University-of-Dayton-DIMLab/Smart-Nozzle/README.md

# Smart Nozzle

Soft Robotics Project Intended for Industrial Coolant Applications
