University-of-Dayton-DIMLab/Smart-Nozzle/Documentation/Progress Powerpoints/5.pptx

## 5/25/2022

## Last Week

- Touch base with kyle and find good assembly
- Print design
- 2 designs, fins and bias
- Work on whatever kyle didn’t finish
- Helix exploration
- Refine 3 chamber design

## Biased model

- 20 degree bend added to Kyle’s printed model

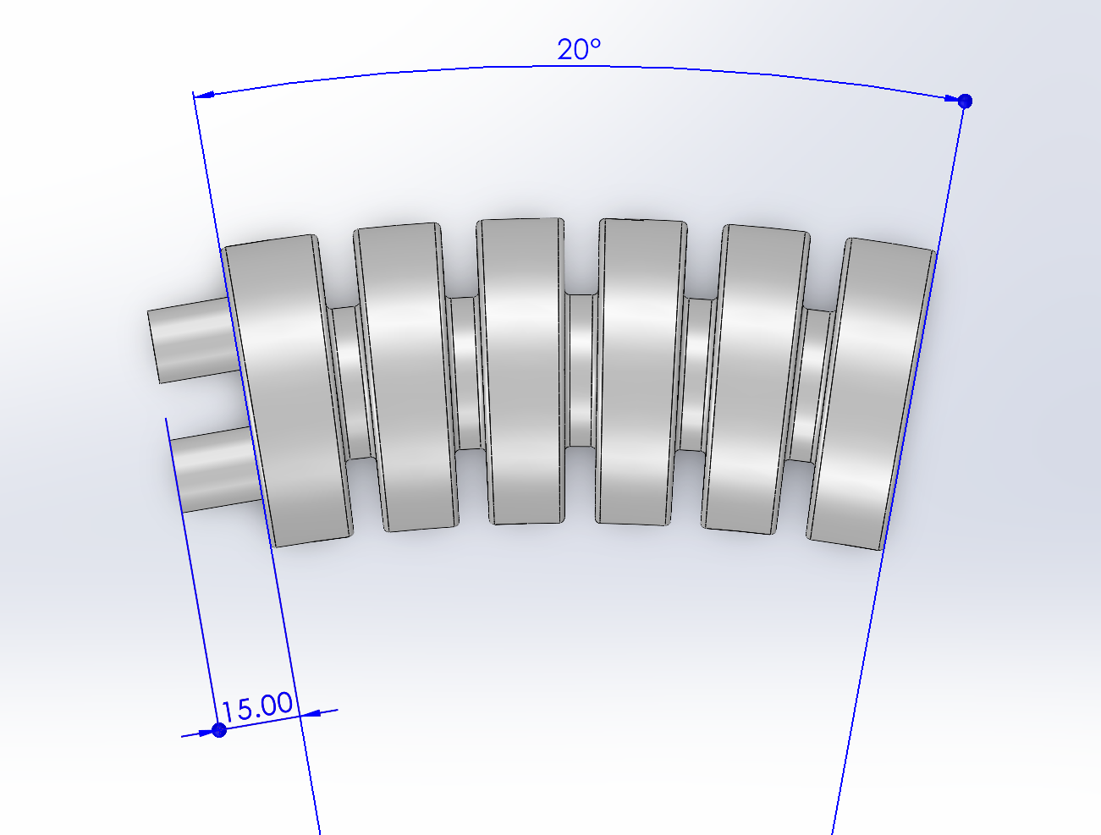
[picture p37: figure]

## Biased model with vacuum

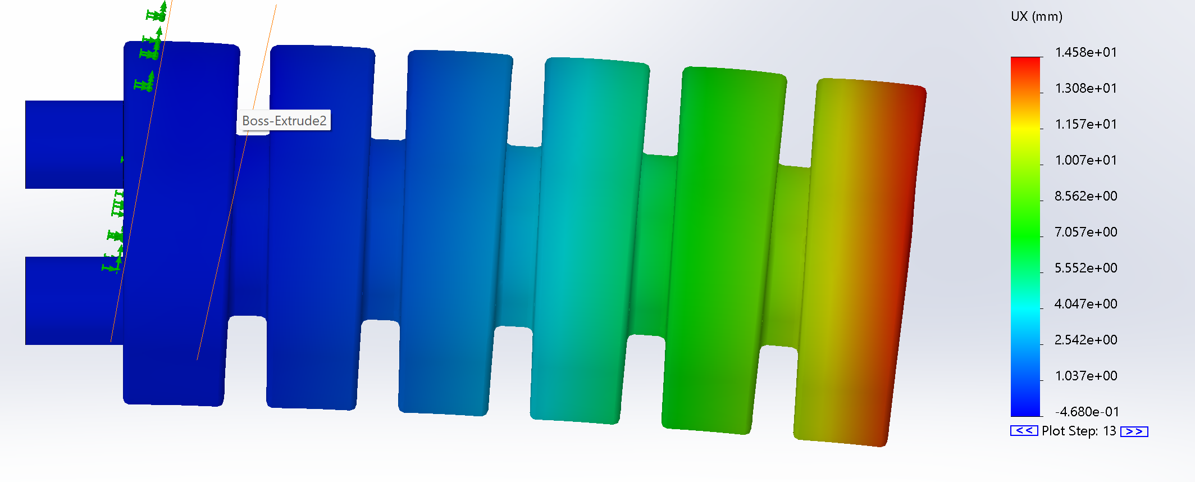
[picture p38: figure]

## Bottom chambers pressurized

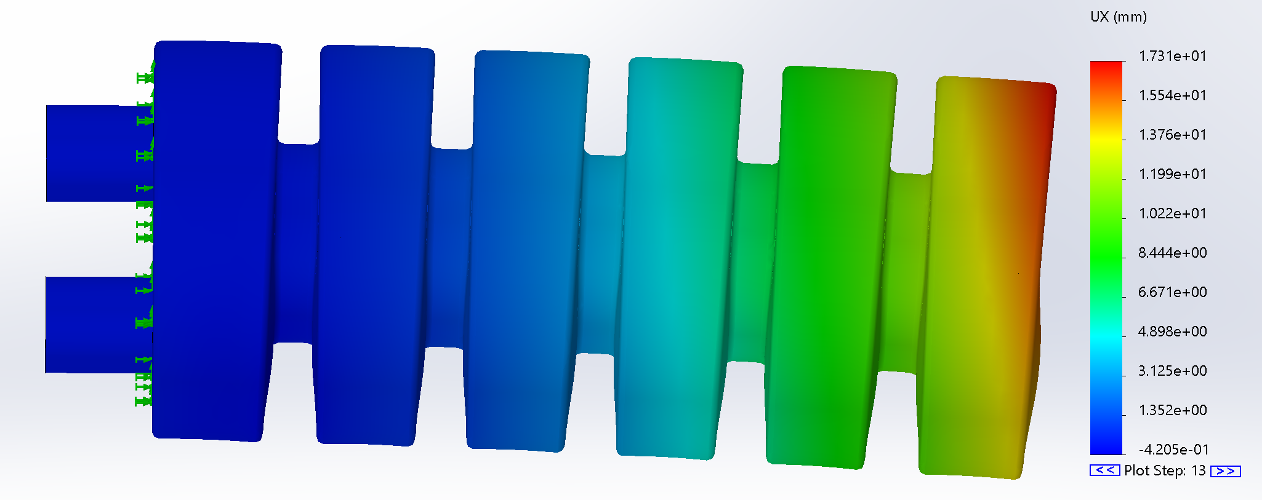
[picture p39: figure]

## Fin Model

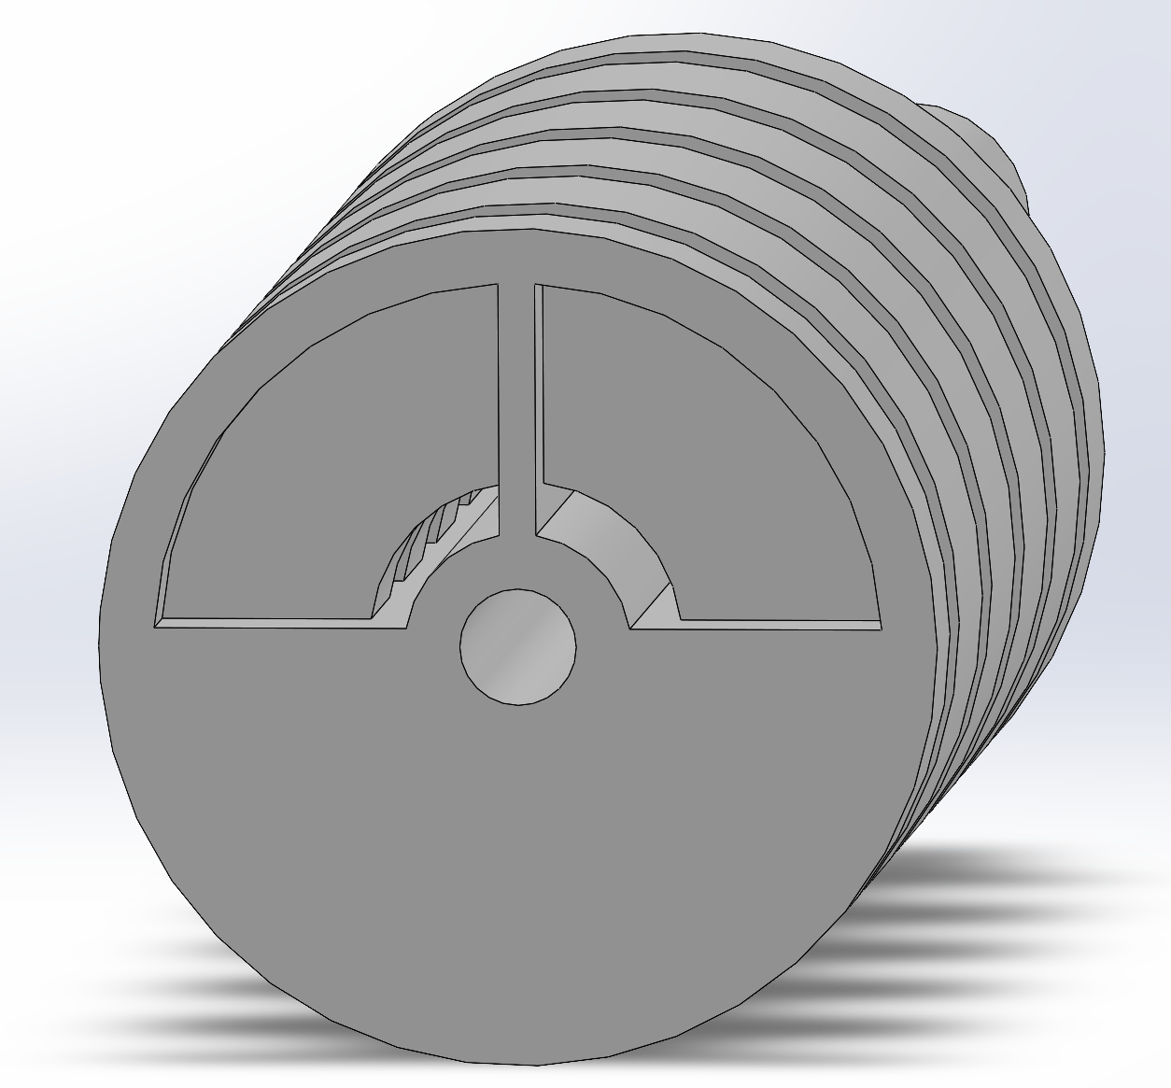
[picture p40: figure]

## Fin Model

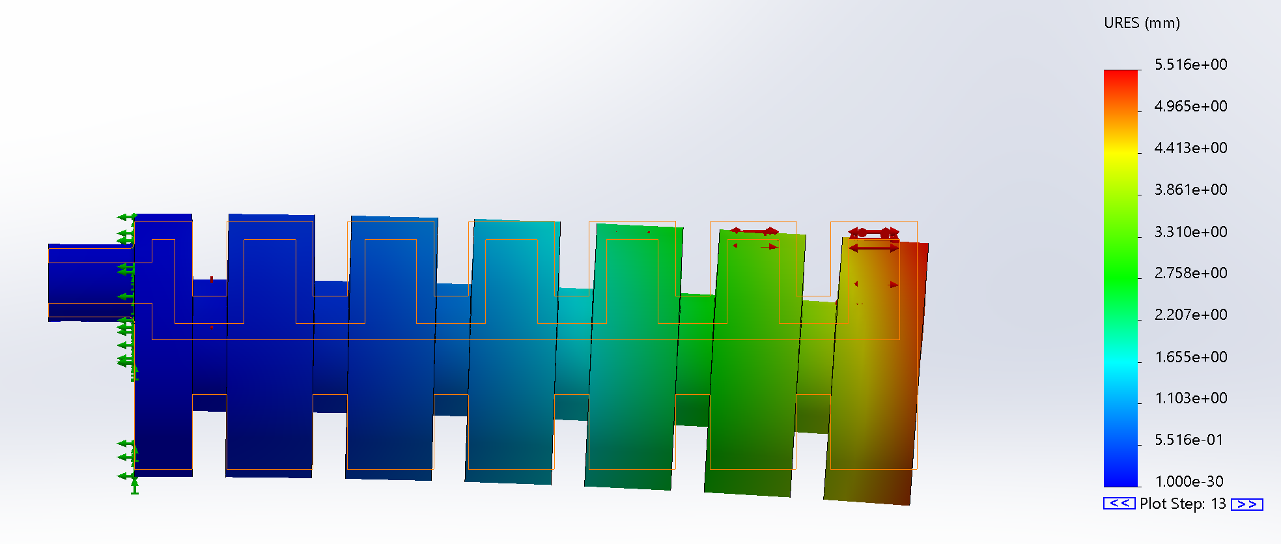
[picture p41: figure]

## Non fin model for control

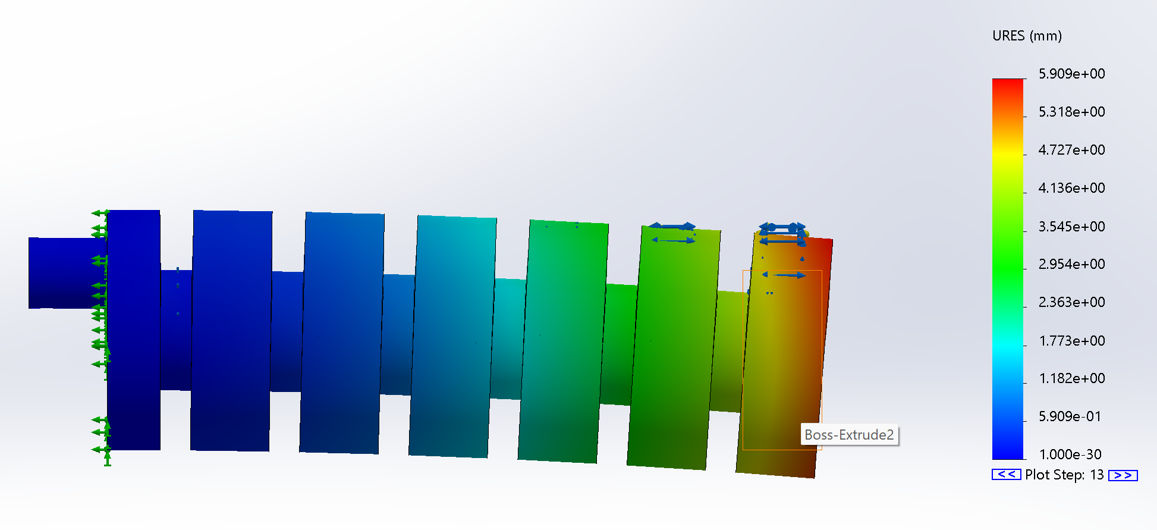
[picture p42: figure]

## Fin One Chamber

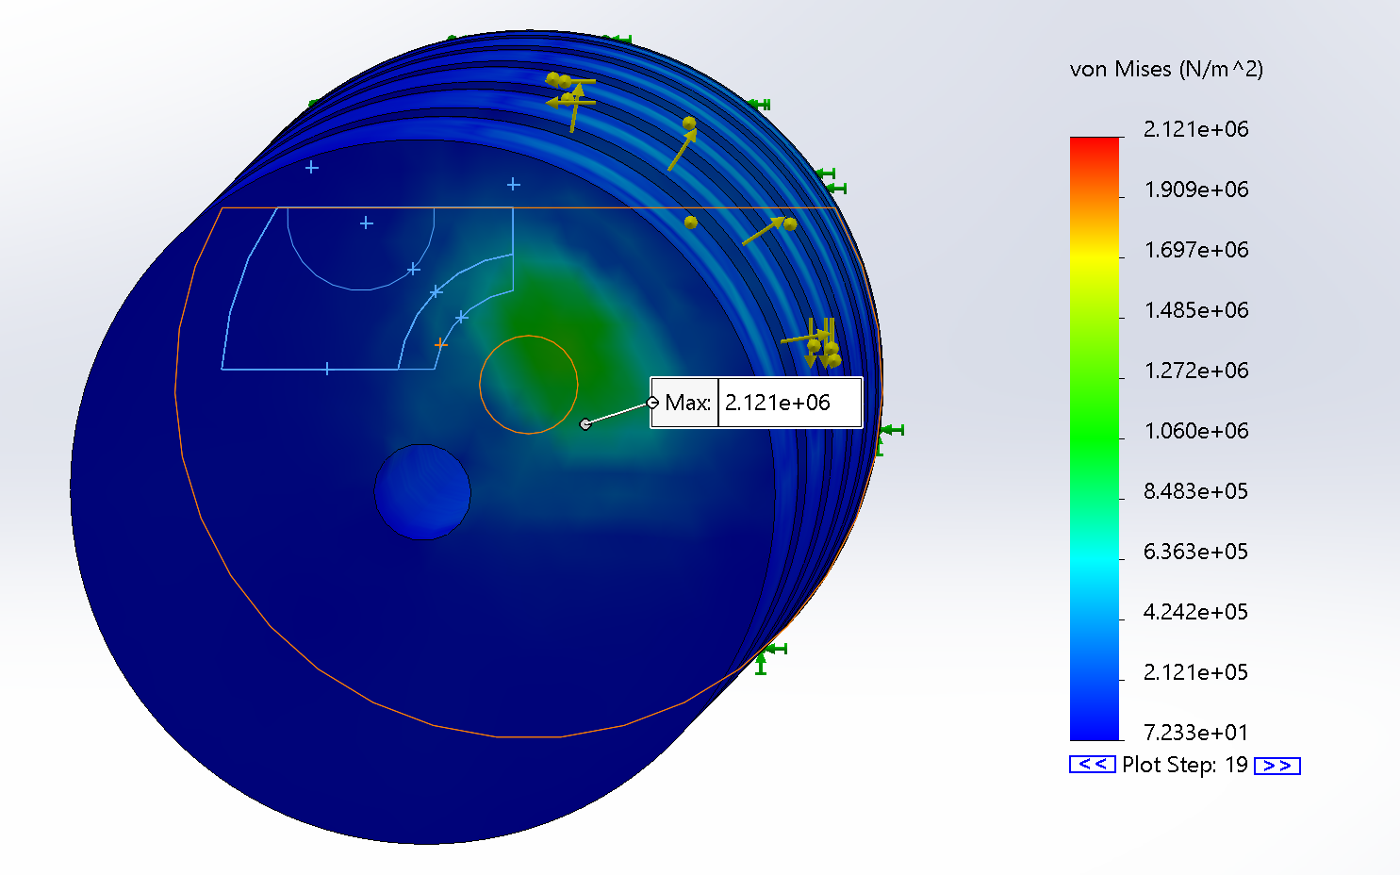
[picture p43: figure]

## Helix

- 24 mm pitch 1 cm OD 6mm ID Centered Hole

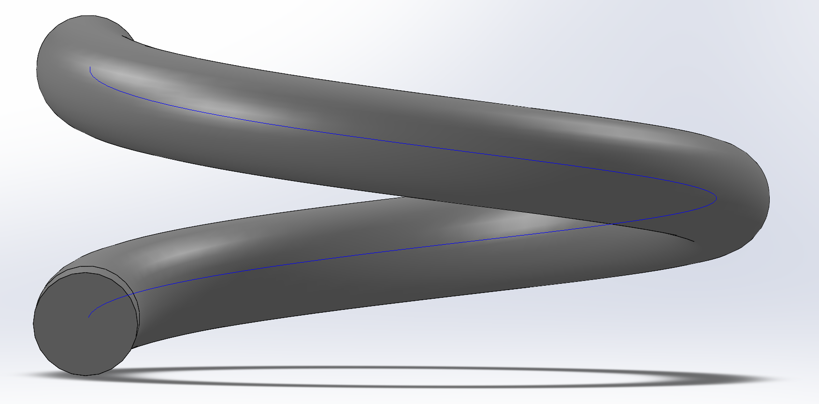
[picture p44: figure]
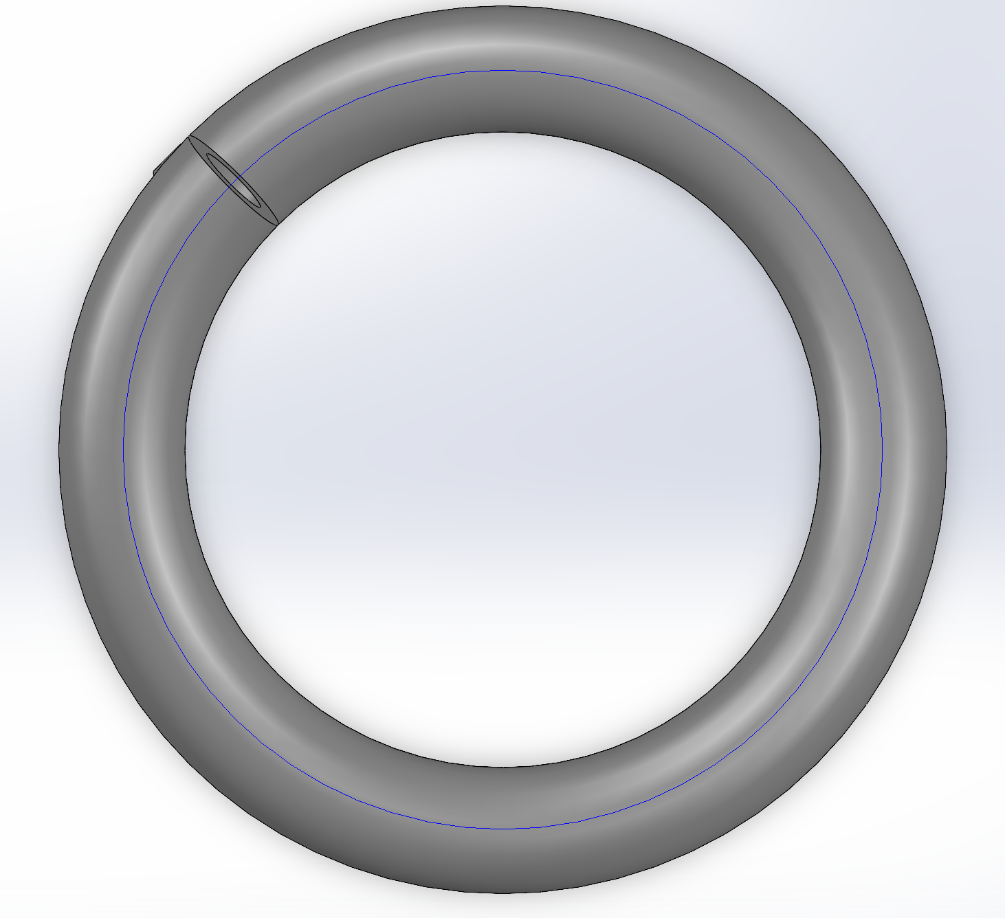
[picture p45: figure]

## Slide 11

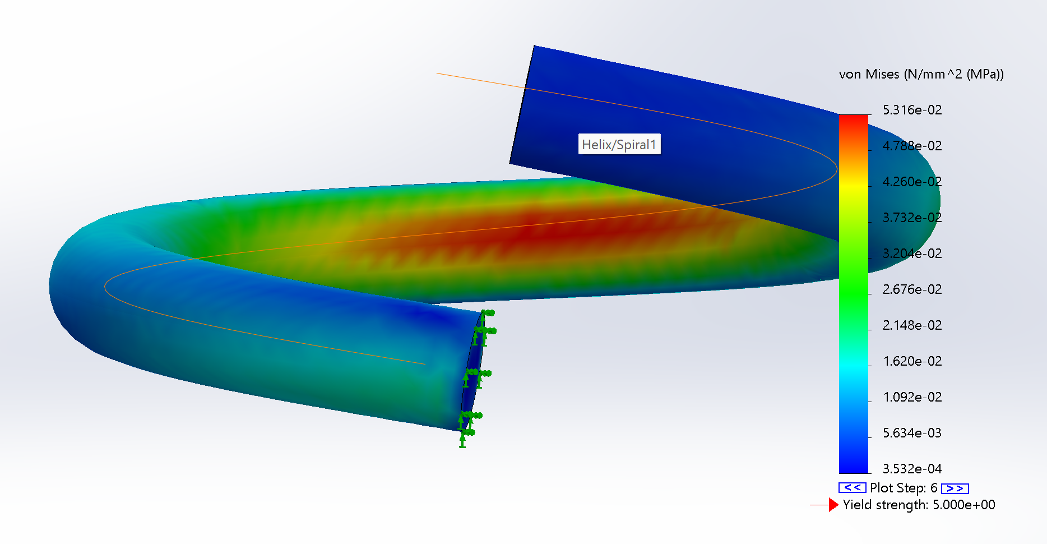
[picture p46: figure]

## For Next Week

- Develop two new models
  - Biased model with cylindric pieces not using flex tool
  - Fin design without fins
- Rebuild 3 chamber to proper spec
- Simulate the four models (two above, 3 and 4 chamber designs)
  - Run same simulations on all models to draw comparisons
- More iterations of the Helix (square)
- Follow up with Ally about print request Friday early or Thursday late
- Check in with Kyle about simulations on his models to check validity
