University-of-Dayton-DIMLab/Smart-Nozzle/Documentation/Progress Powerpoints/6-1-22.pptx

## From Last Weeks Meeting

- Develop two new models
  - Biased model with cylindric pieces not using flex tool
  - Fin design without fins
- Rebuild 3 chamber to proper spec
- Simulate the four models (two above, 3 and 4 chamber designs)
  - Run same simulations on all models to draw comparisons
- Follow up with Ally about print request Friday early or Thursday late
- Check in with Kyle about simulations on his models to check validity
- More iterations of the Helix (square)

6/1/22

## 3 Chamber

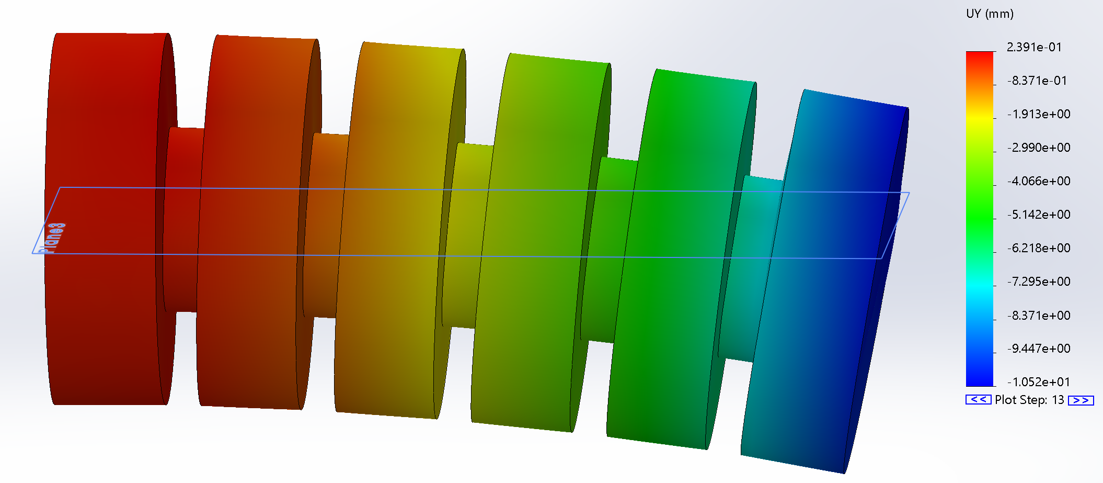
[picture p47: figure]
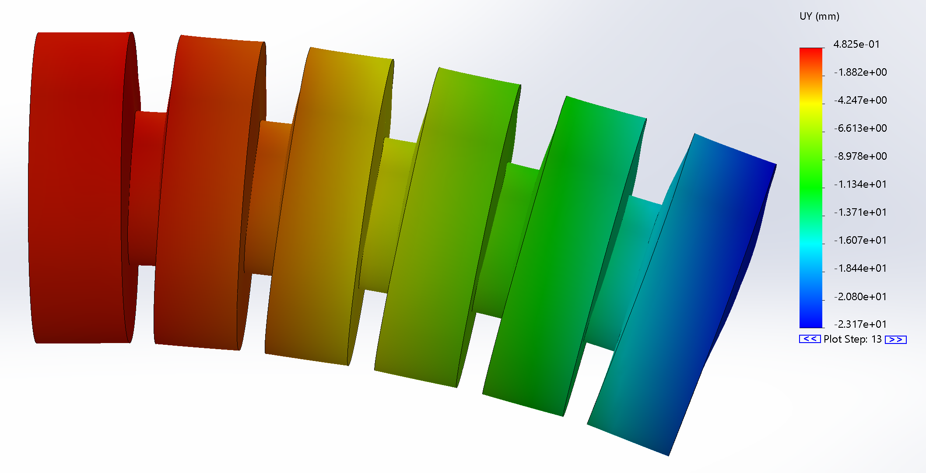
[picture p48: figure]
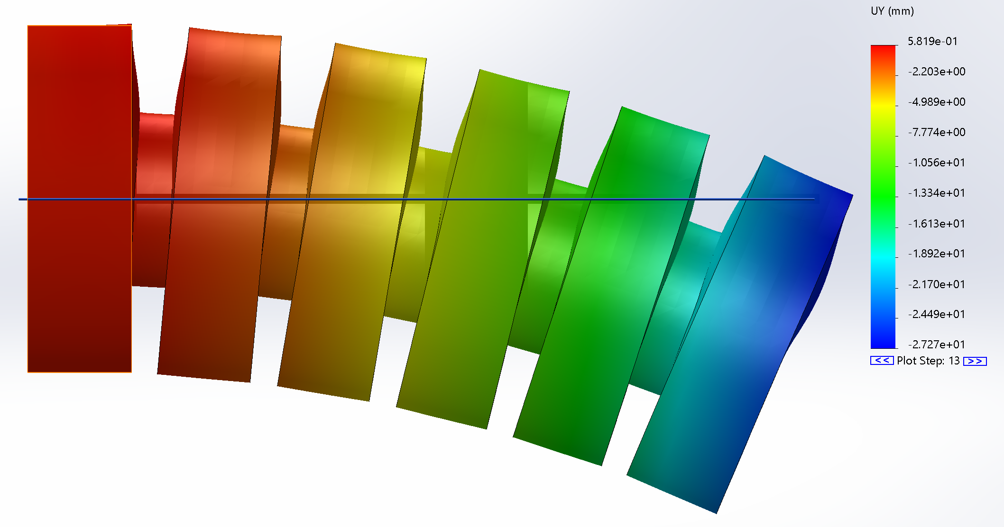
[picture p49: figure]

## 4 Chamber

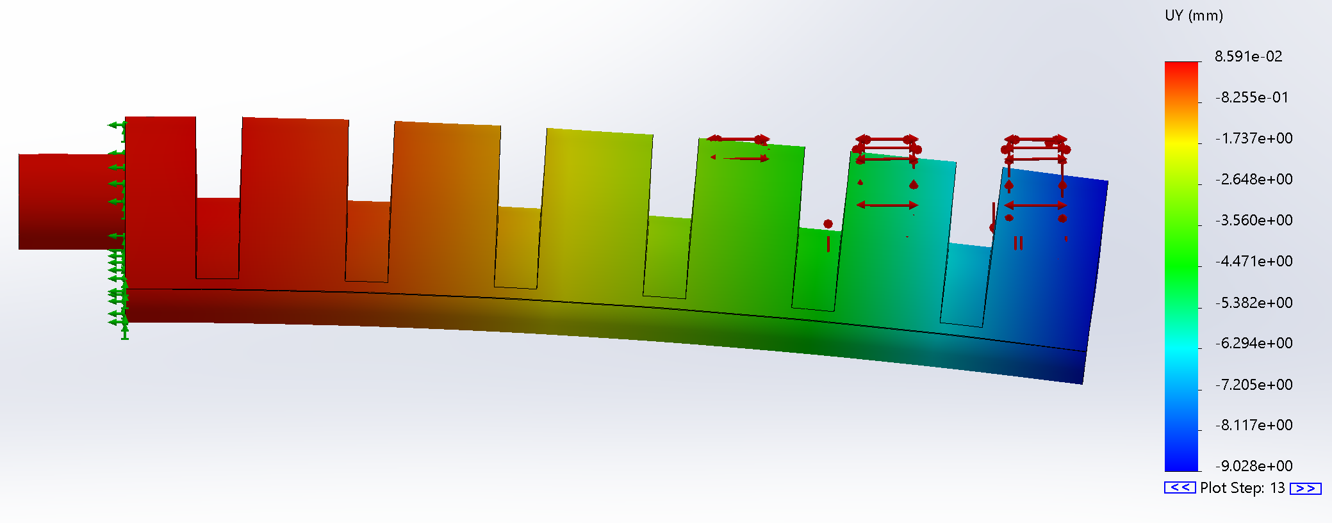
[picture p50: figure]
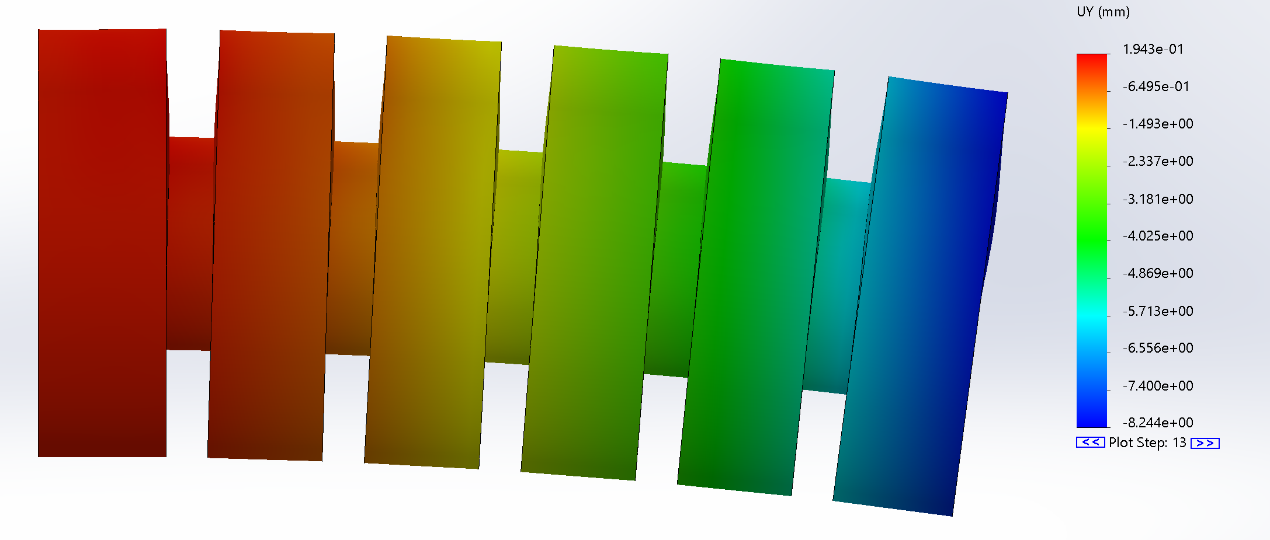
[picture p51: figure]
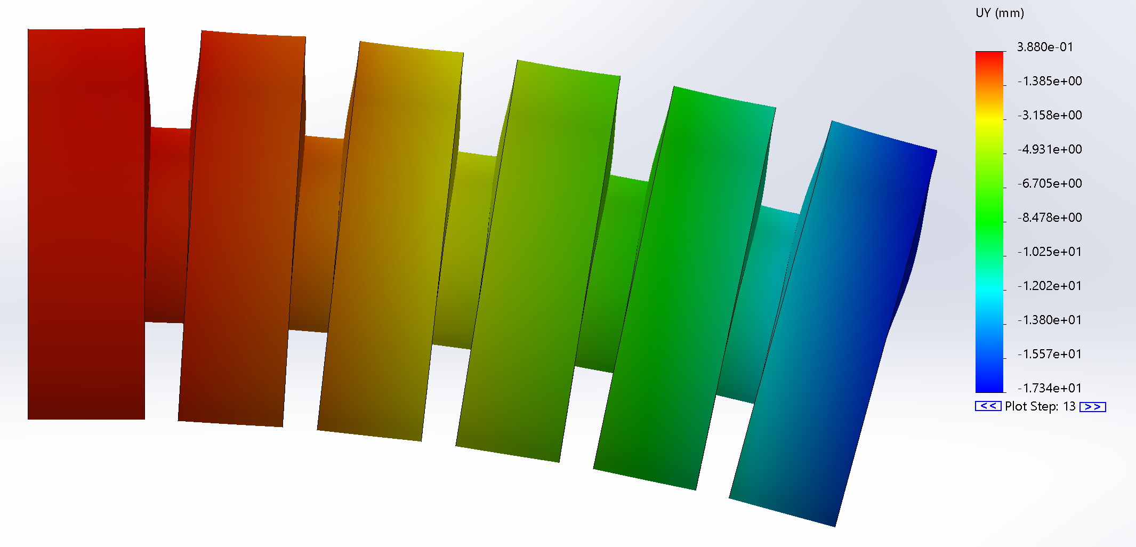
[picture p52: figure]
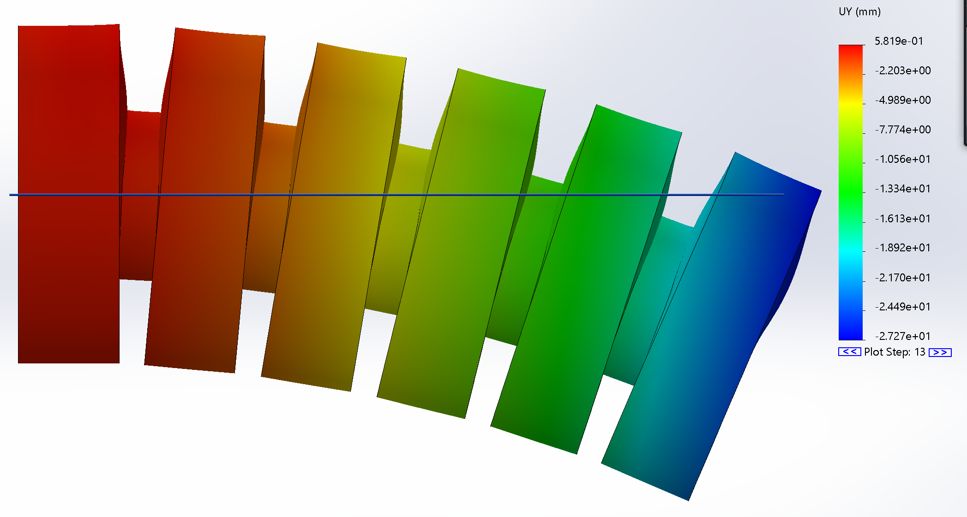
[picture p53: figure]

## Finless Model

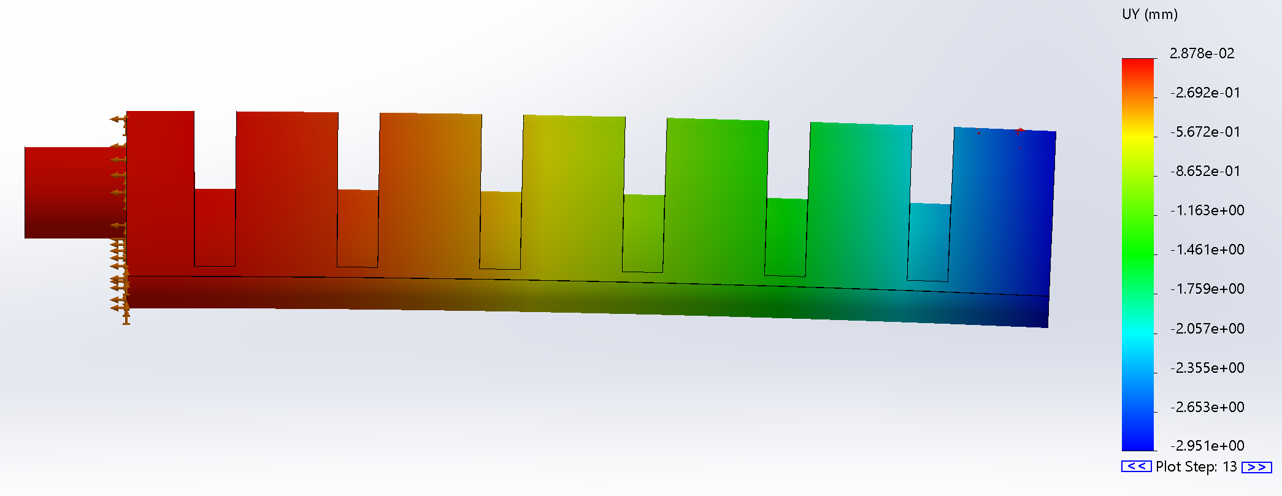
[picture p54: figure]
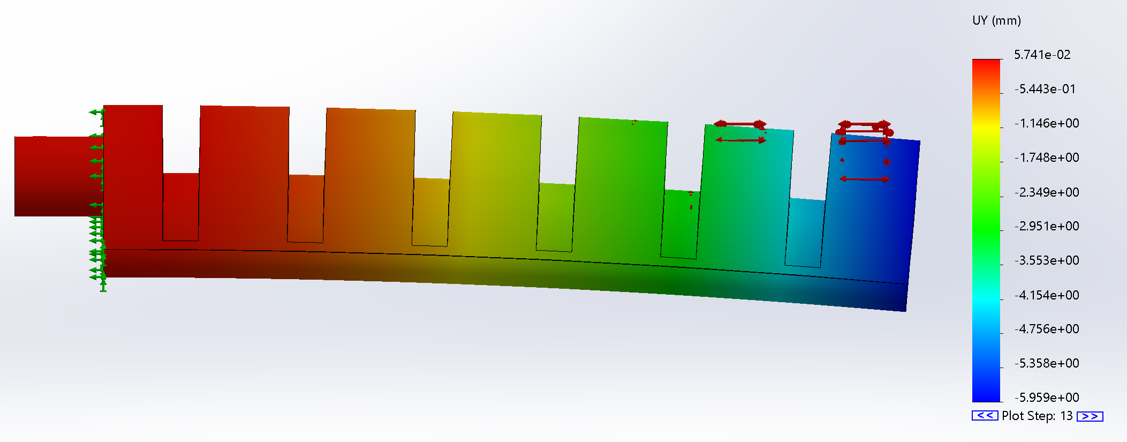
[picture p55: figure]

## For Next Week

- Reach out to jack about 272
- Prove symmetry for 0 10, 10 0 for 3 and 4 chamber design
- Further explore controllability of each nozzle design
  - 0-30psi
  - Build Table as discussed
- Build and simulate finless model to proper spec
- Remind Drew to email Ally if we haven’t heard from her
- Work on square helix design
