University-of-Dayton-DIMLab/Smart-Nozzle/Documentation/Progress Powerpoints/6-29-22.pptx

## Last Week

- Make PowerPoint For Friday
  - Get more pictures of bad prints
  - What Questions need to come up?
    - What can we do for the next print? What can they do for the next print? Questions like this need to come up
- Build Testing Rig after part delivery
- Hopefully meeting leads to work (Fri 9:15am)
  - Embrace variety around the two chamber model. Larger filets and rounds. Donuts instead of burgers. 4 chambers . 6 chambers but small. Brat size instead of white claw size. Get varieties of each
- Helix with offset chamber and more space between layers
- Hexagonal/Octagonal helix
- Review assembling and animating a 4 bar mechanism connected by revolute or prismatic joints

## Highlighter design

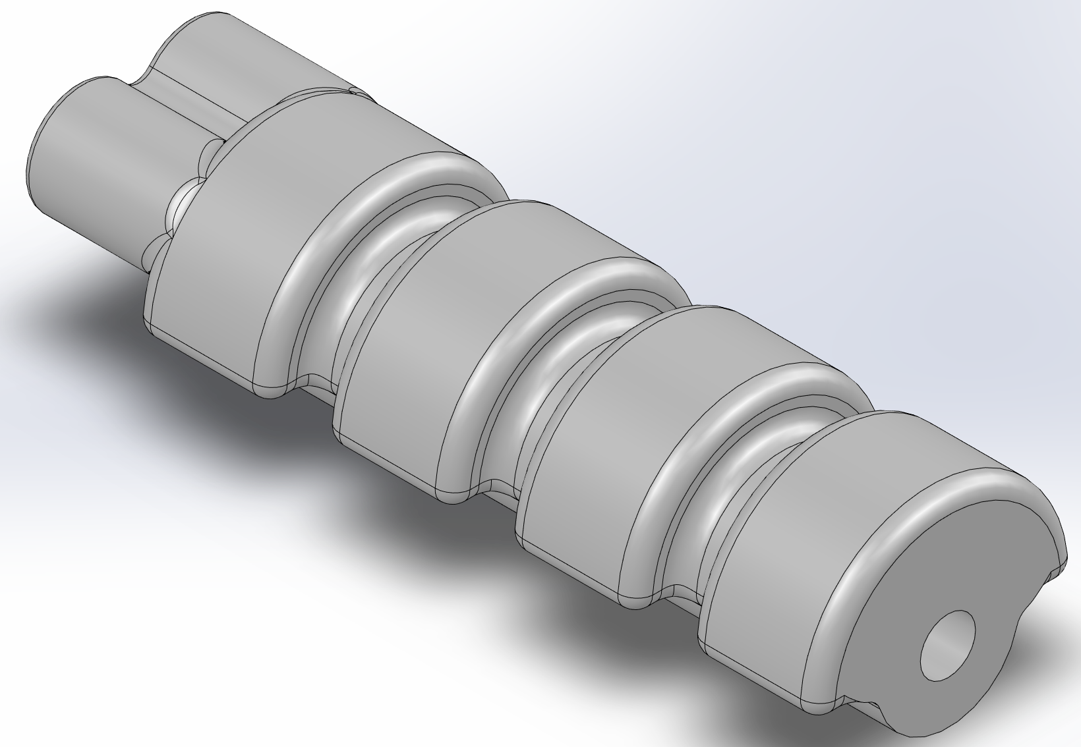
[picture p56: figure]
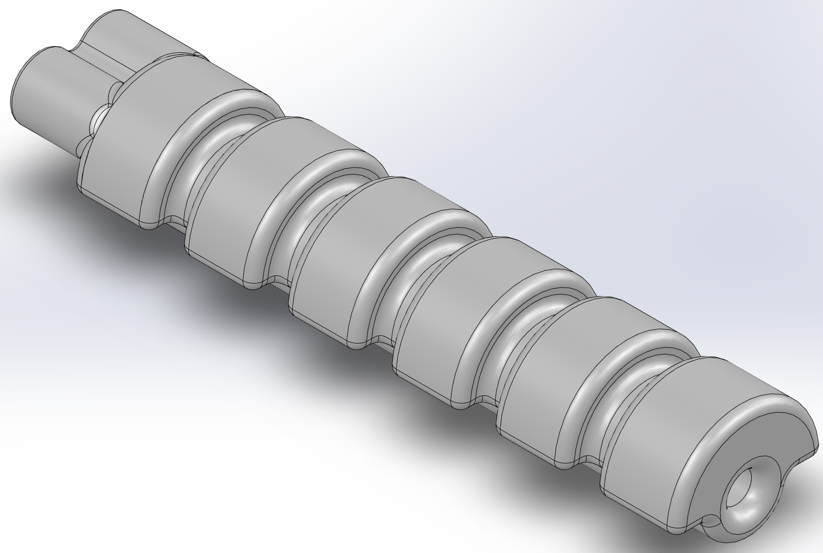
[picture p57: figure]
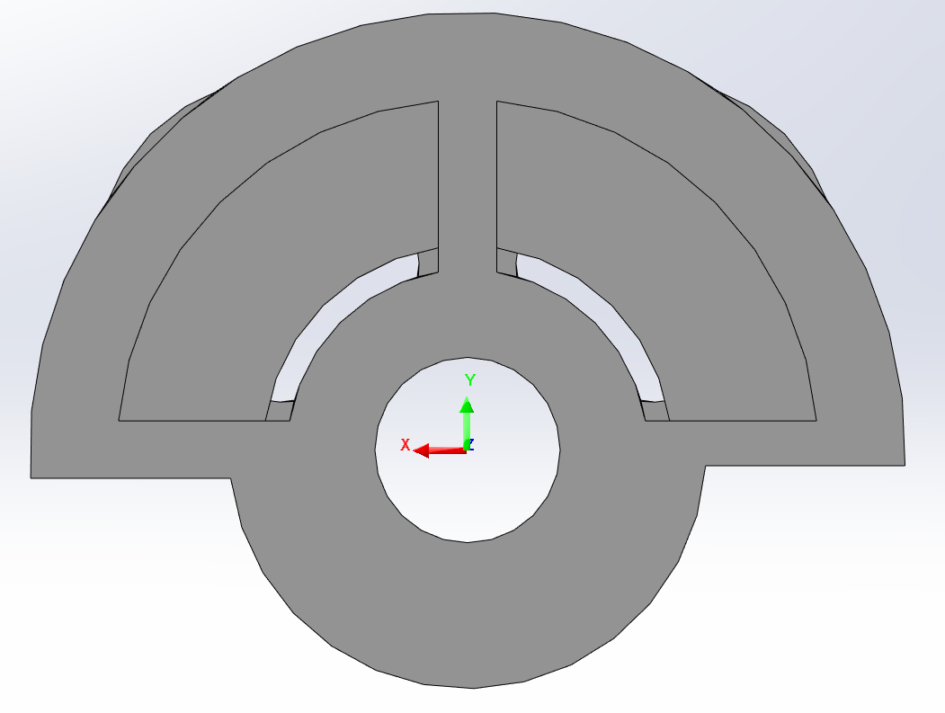
[picture p58: figure]

## Torus Design

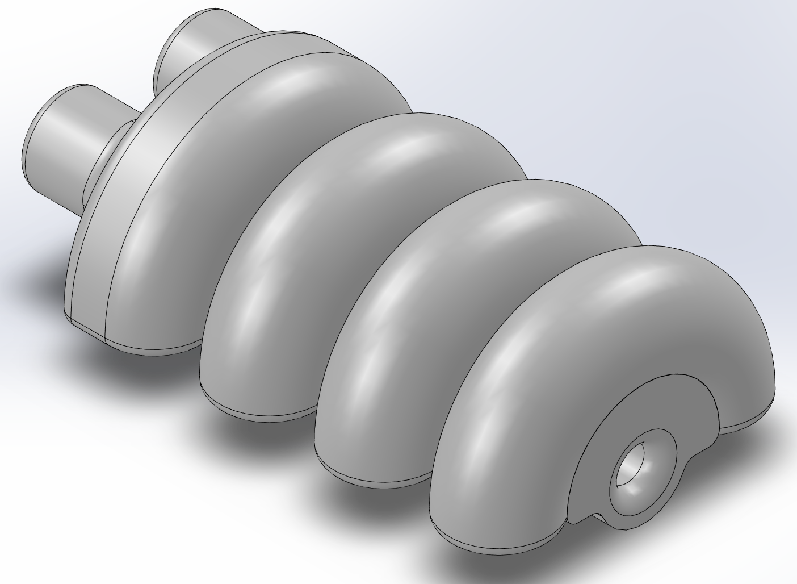
[picture p59: figure]
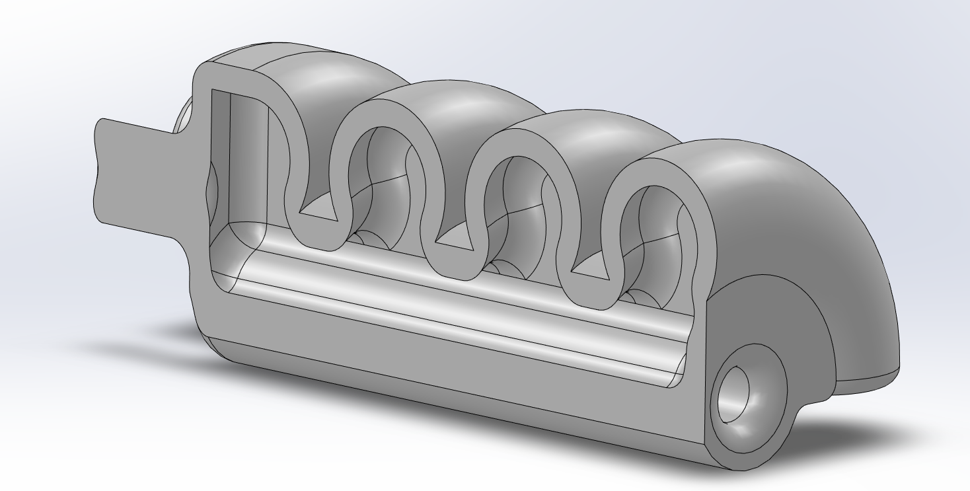
[picture p60: figure]
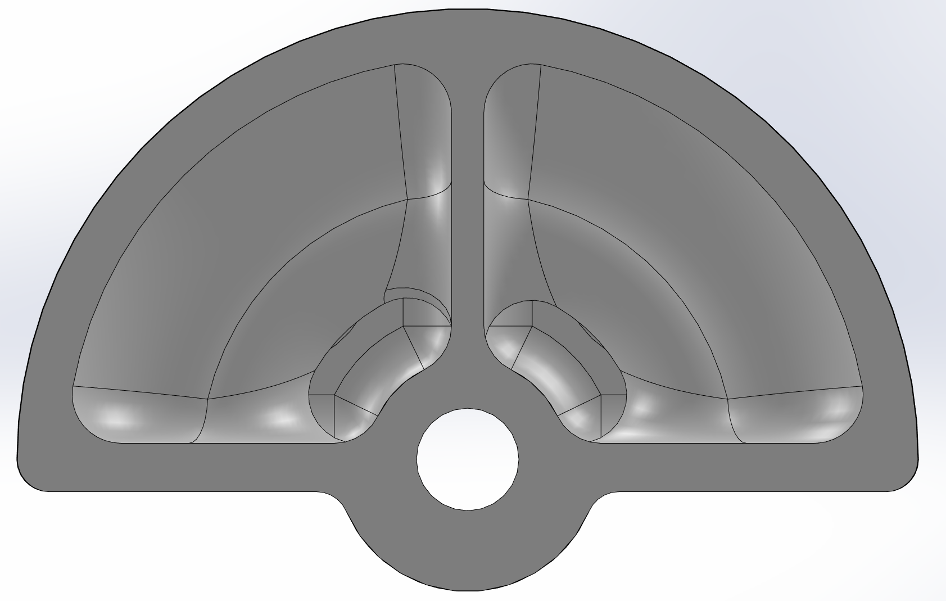
[picture p61: figure]
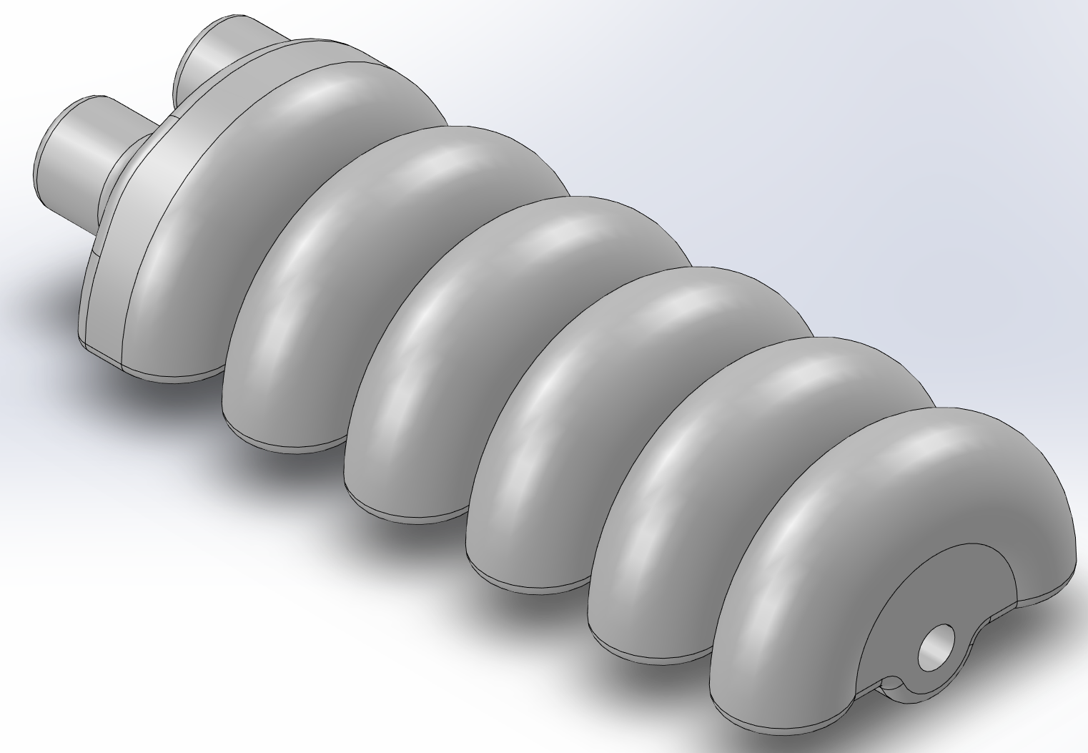
[picture p62: figure]

## Larger Fillets

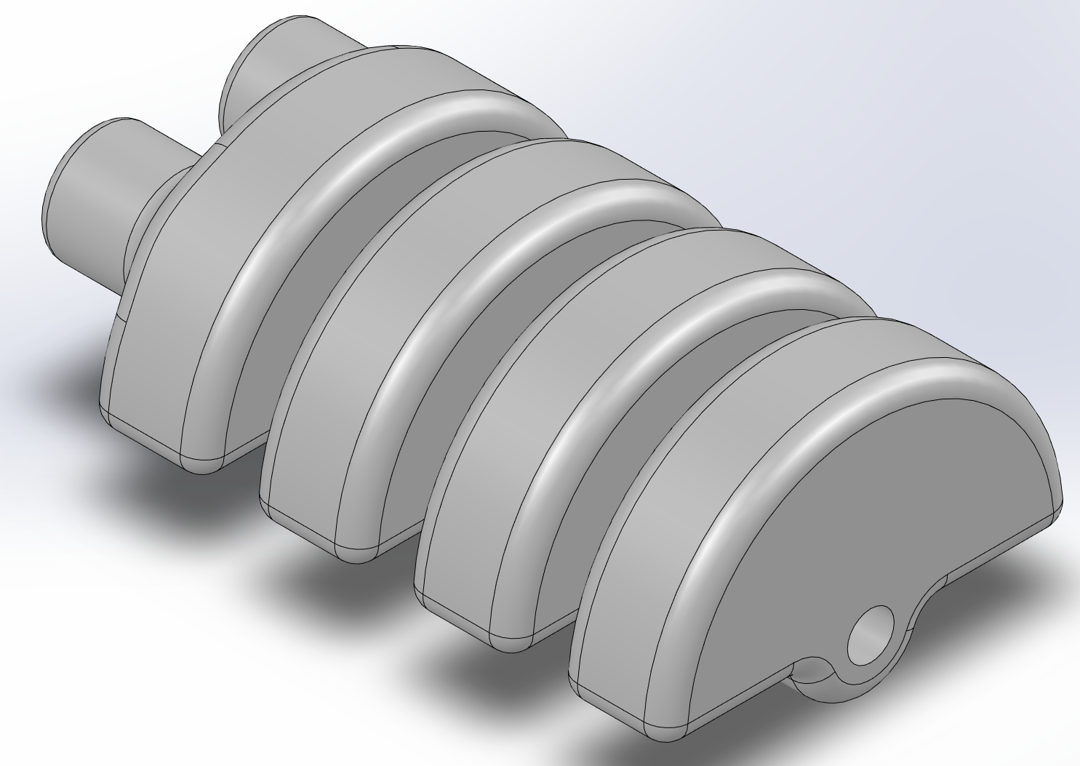
[picture p63: figure]
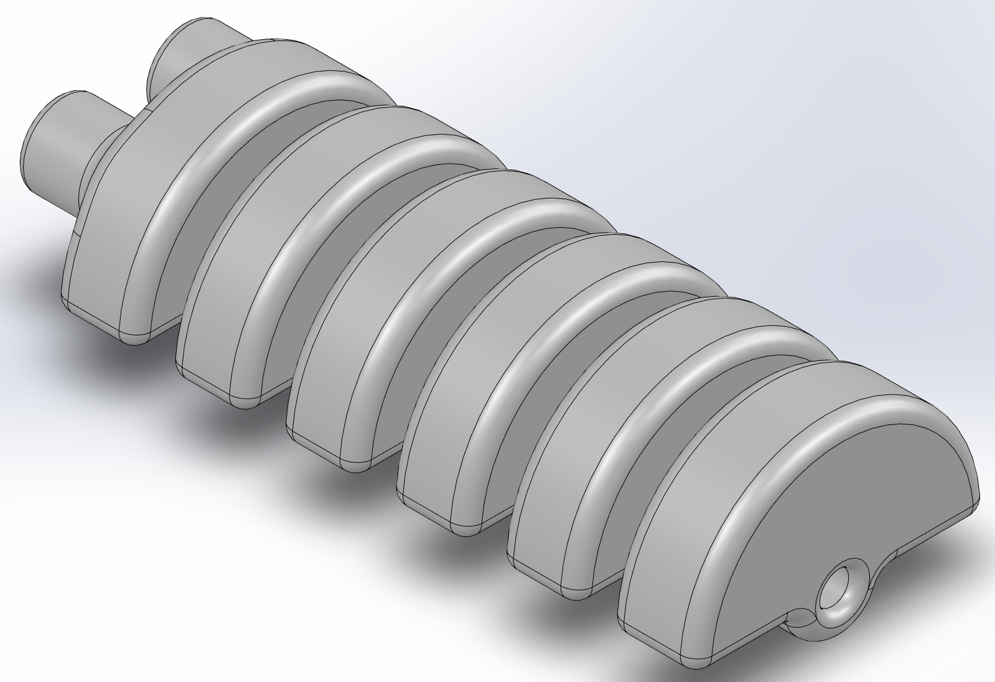
[picture p64: figure]

## For Next Week

- Design work
  - small diameter torus long and short
  - Reconcile rounds and send parts off for printing
- Try to run water through the model
  - Need to make fitting for nozzle
- Look at CFD fluid give this a few hours
- Review Soft Robot Toolkits
- Build Testing Rig
- Review assembling and animating a 4 bar mechanism connected by revolute or prismatic joints
- Helix with offset chamber and more space between layers
- Hexagonal/Octagonal helix

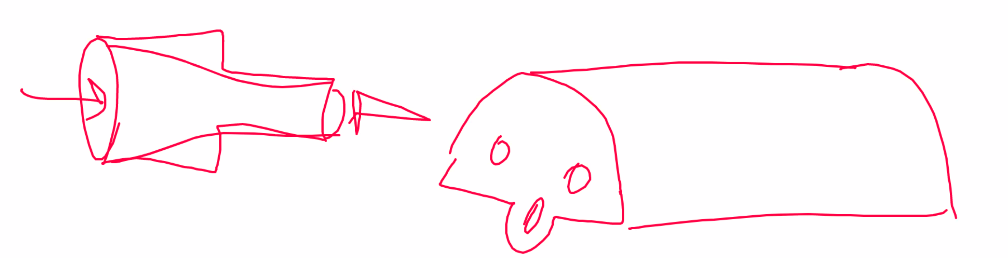
[picture p65: figure]
