University-of-Dayton-DIMLab/Smart-Nozzle/Documentation/Material Properties/Material Properties - Email from Dr. Lowe.pdf

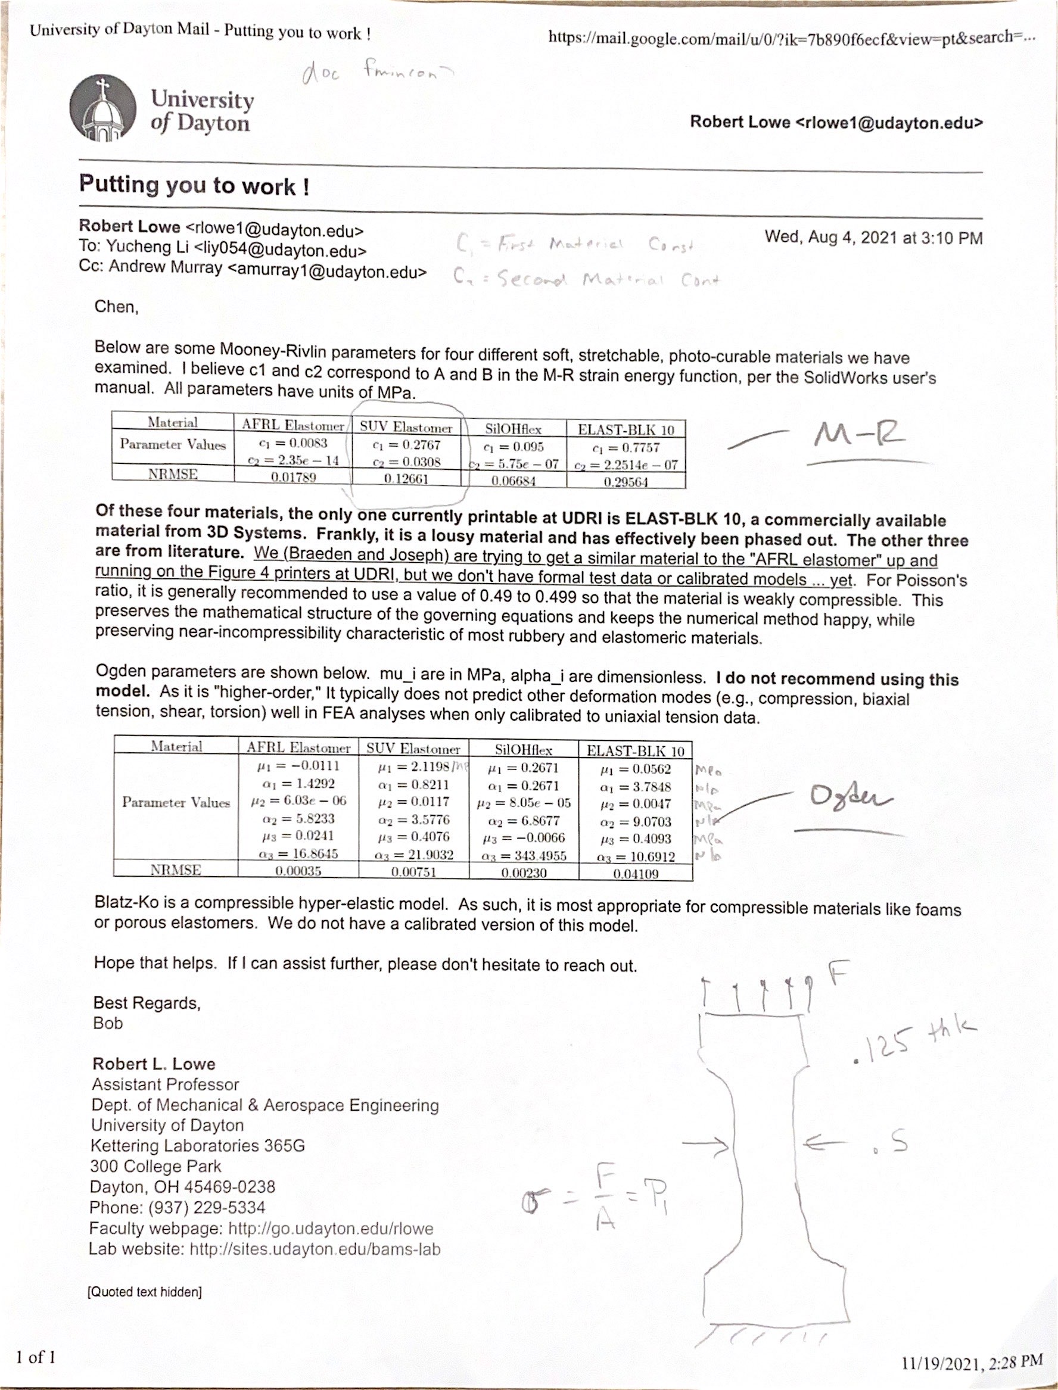
[picture p79: page 1]
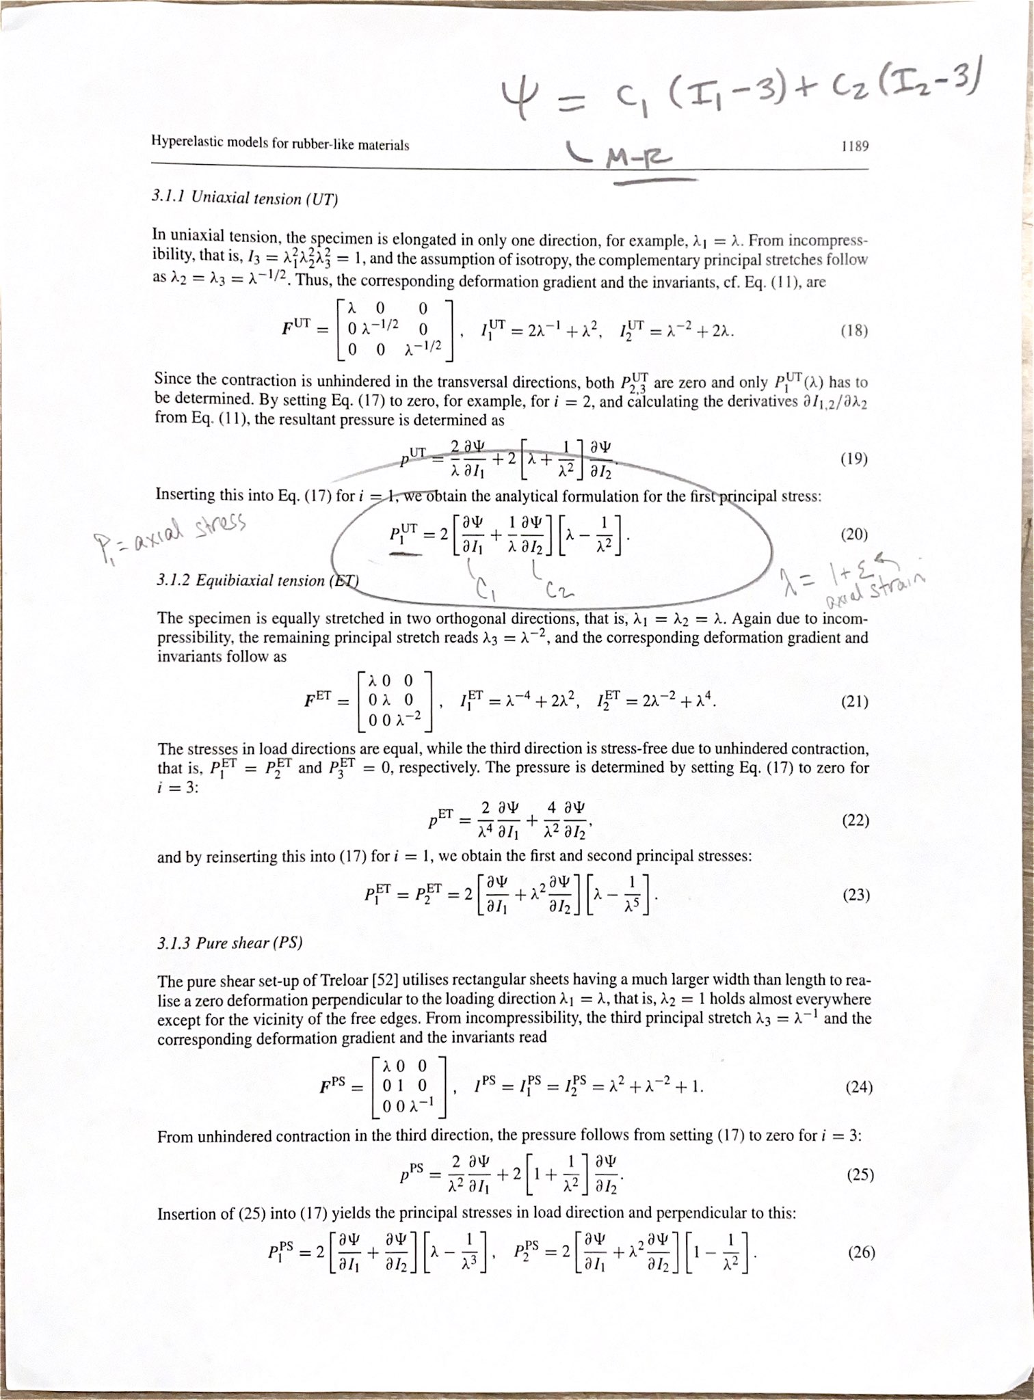
[picture p80: page 2]
