University-of-Dayton-DIMLab/Smart-Nozzle/Documentation/Material Properties/65A Material Properties (Data Sheet).jpg

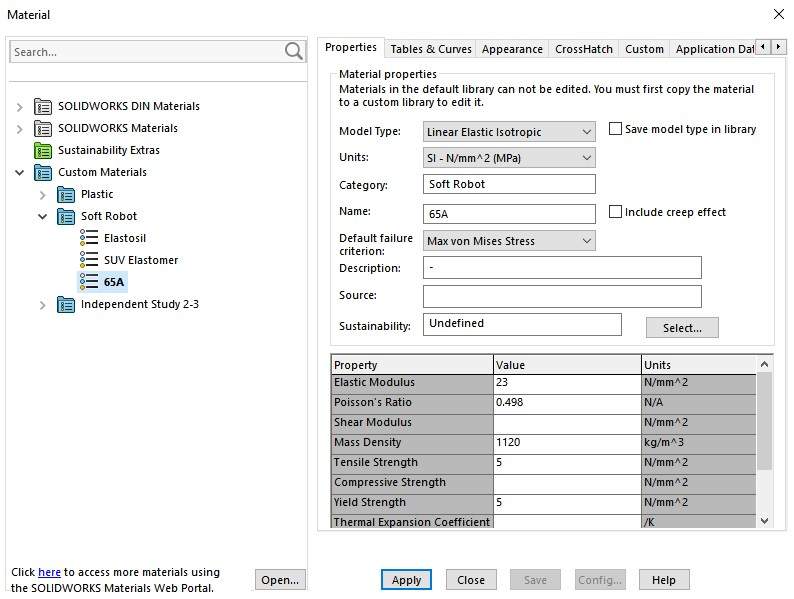
Documentation/Material Properties/65A Material Properties (Data Sheet).jpg
