University-of-Dayton-DIMLab/Smart-Nozzle/Documentation/Material Properties/Engineering to True SS.jpg

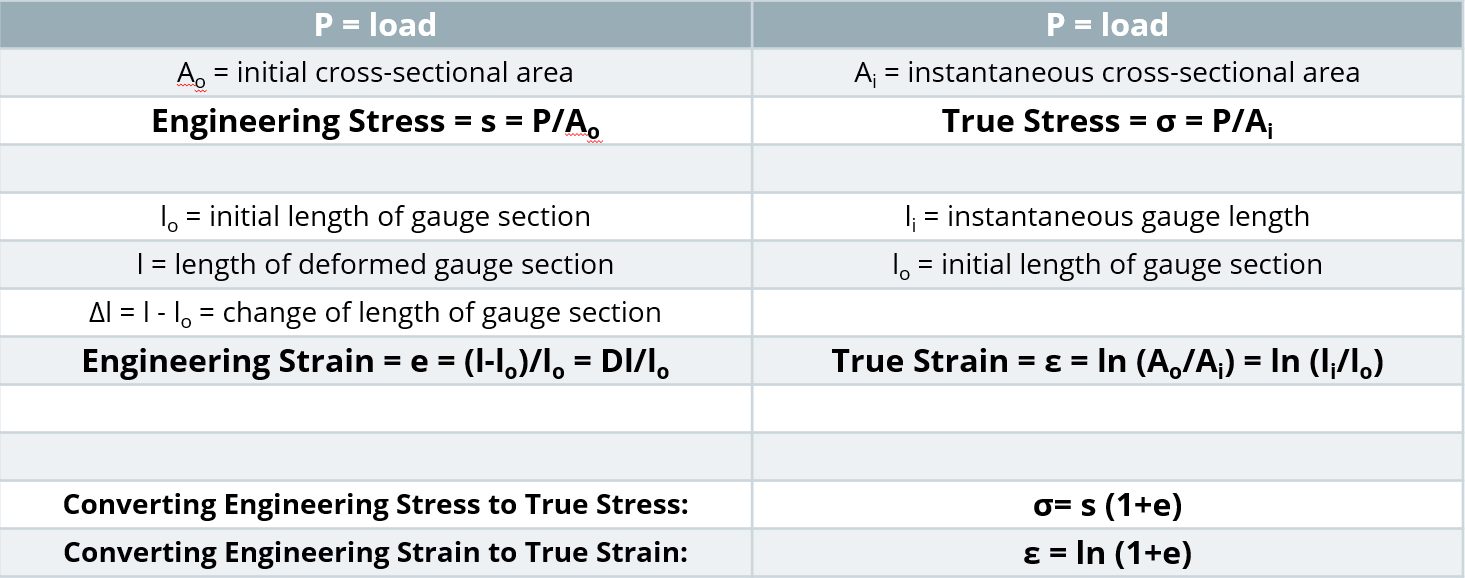
Documentation/Material Properties/Engineering to True SS.jpg
