University-of-Dayton-DIMLab/Smart-Nozzle/Documentation/Material Properties/SS Data Eng Values Graphed Linear Fit.jpg

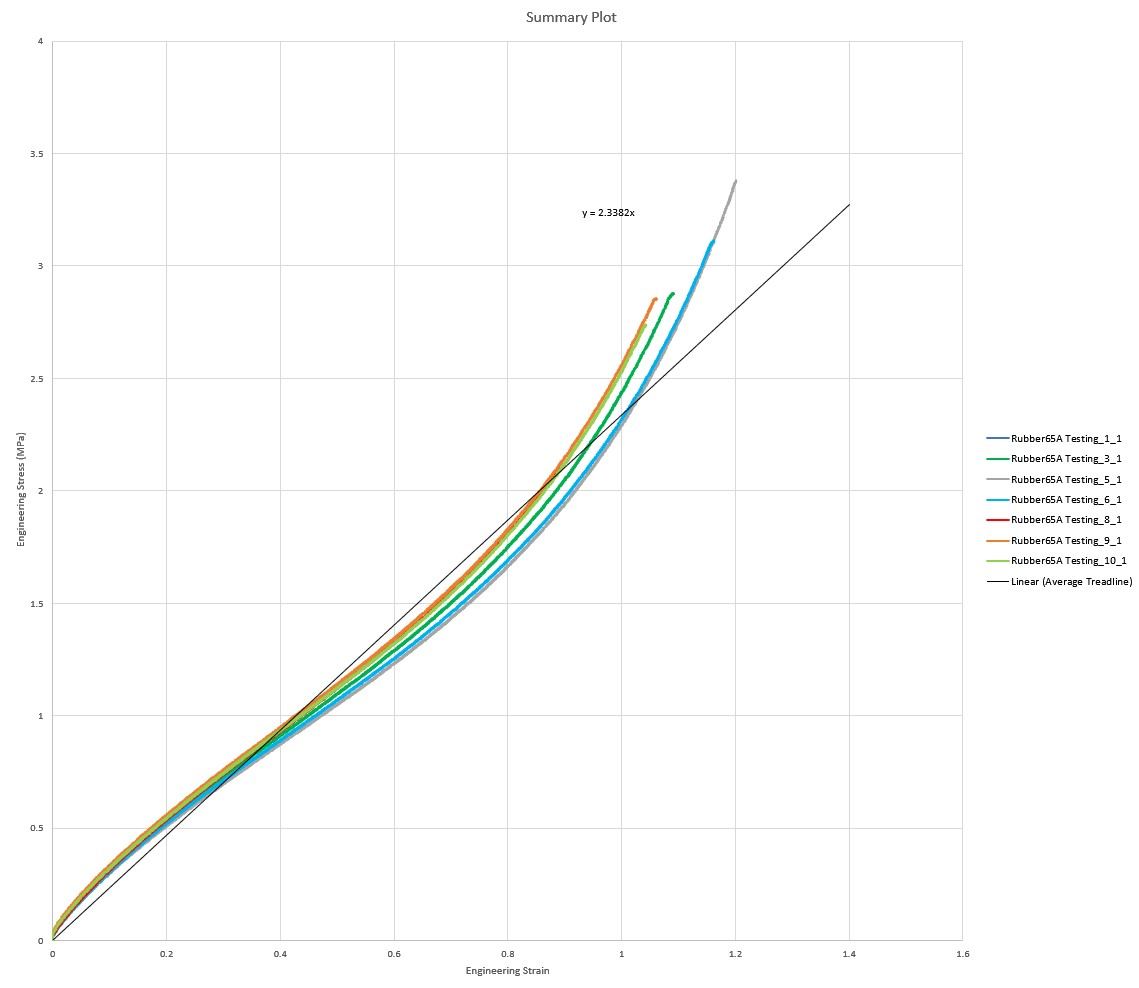
Documentation/Material Properties/SS Data Eng Values Graphed Linear Fit.jpg
