University-of-Dayton-DIMLab/Smart-Nozzle/Documentation/Material Properties/SS Data True Values Graphed Linear Fit.jpg

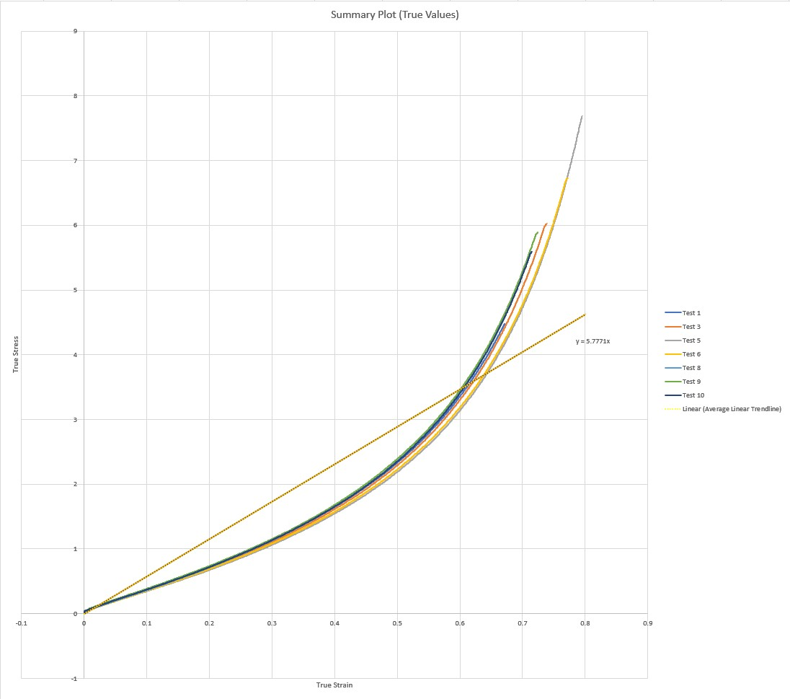
Documentation/Material Properties/SS Data True Values Graphed Linear Fit.jpg
