University-of-Dayton-DIMLab/Smart-Nozzle/Documentation/Material Properties/SUV Elastomer Properties in SolidWorks.JPG

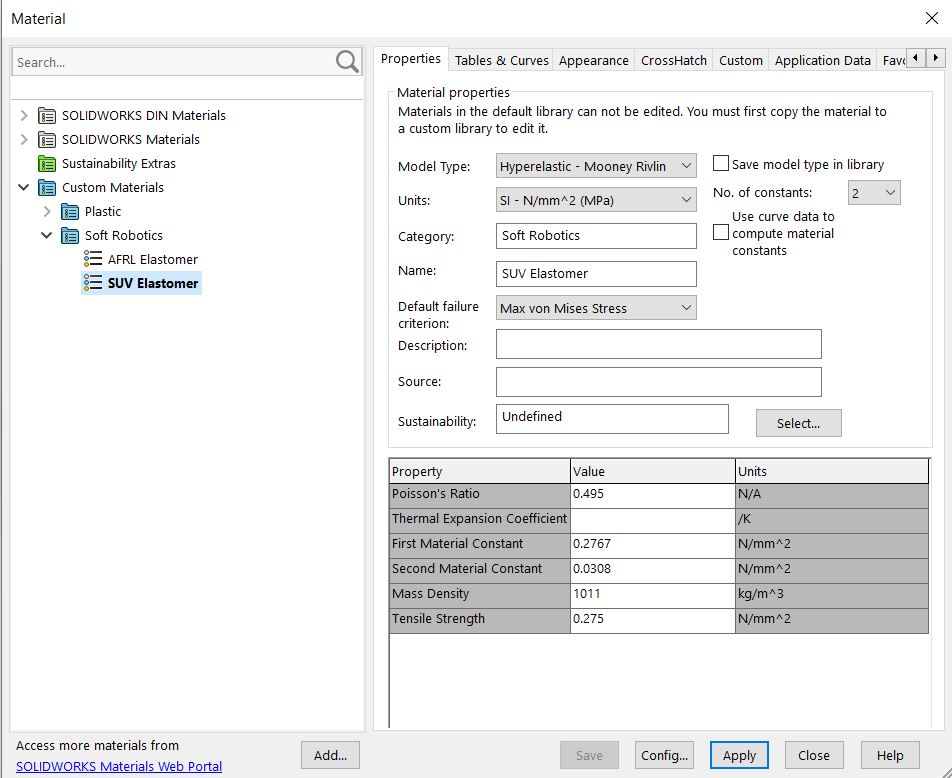
Documentation/Material Properties/SUV Elastomer Properties in SolidWorks.JPG
