University-of-Dayton-DIMLab/Smart-Nozzle/Documentation/FEA Tutorial/Smart Nozzle Tutorial Completed.SLDPRT

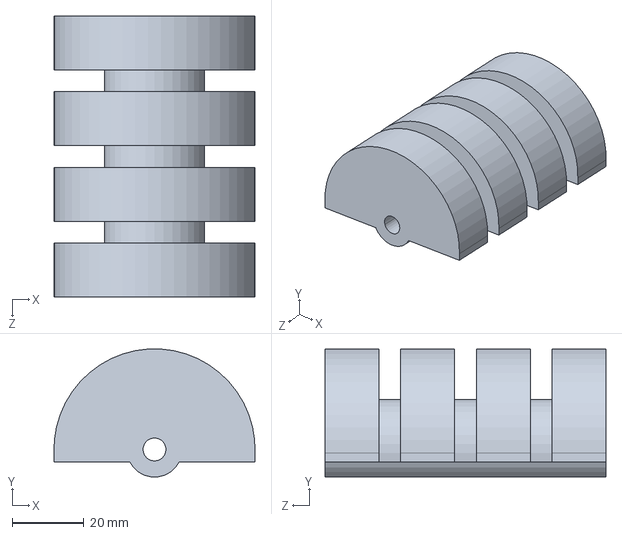
[picture p86: CAD file, 2023-04-17]
Documentation/FEA Tutorial/Smart Nozzle Tutorial Completed.SLDPRT
55.8 x 35.5 x 78.0 mm
