University-of-Dayton-DIMLab/Smart-Nozzle/Documentation/Smart Hose/Displacement Chart Tests/Completed Model C1-0 C2-30.SLDPRT

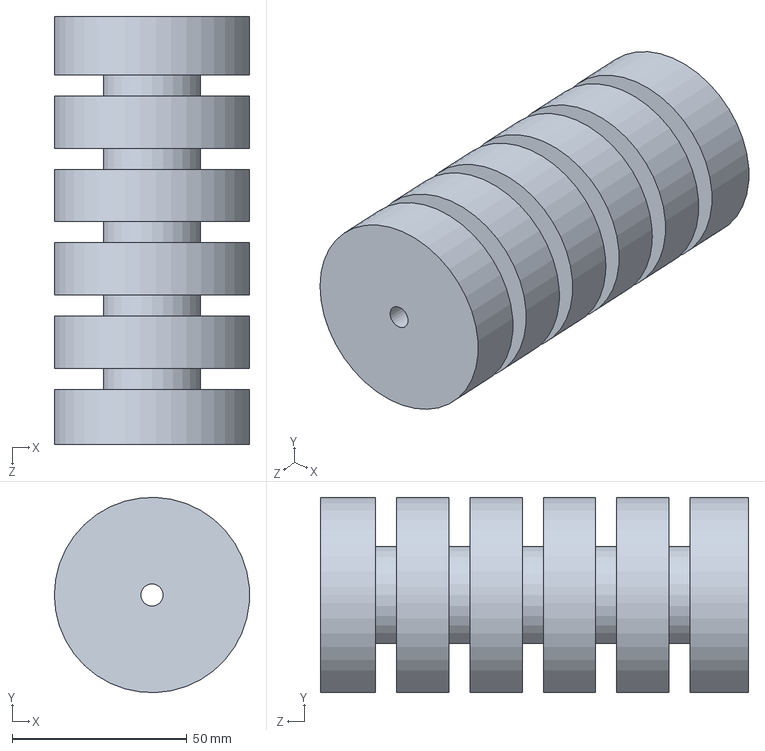
[picture p87: CAD file, 2023-04-17]
Documentation/Smart Hose/Displacement Chart Tests/Completed Model C1-0 C2-30.SLDPRT
55.9 x 55.8 x 122.5 mm
