University-of-Dayton-DIMLab/Smart-Nozzle/CAD/Smart Nozzle Designs/2 chamber Taurus full size.SLDPRT

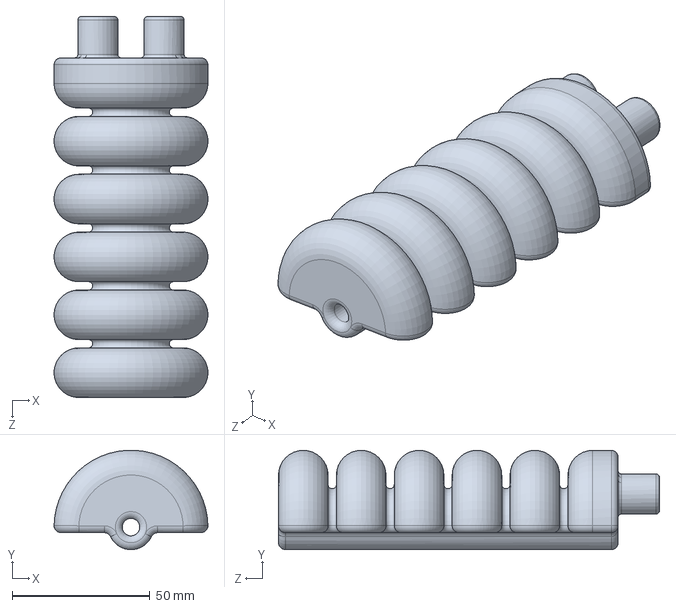
[picture p88: CAD file, 2023-04-17]
CAD/Smart Nozzle Designs/2 chamber Taurus full size.SLDPRT
55.8 x 36.0 x 138.2 mm
