University-of-Dayton-DIMLab/Smart-Nozzle/CAD/Smart Nozzle Designs/FlangedModel/FlangedModel.SLDASM

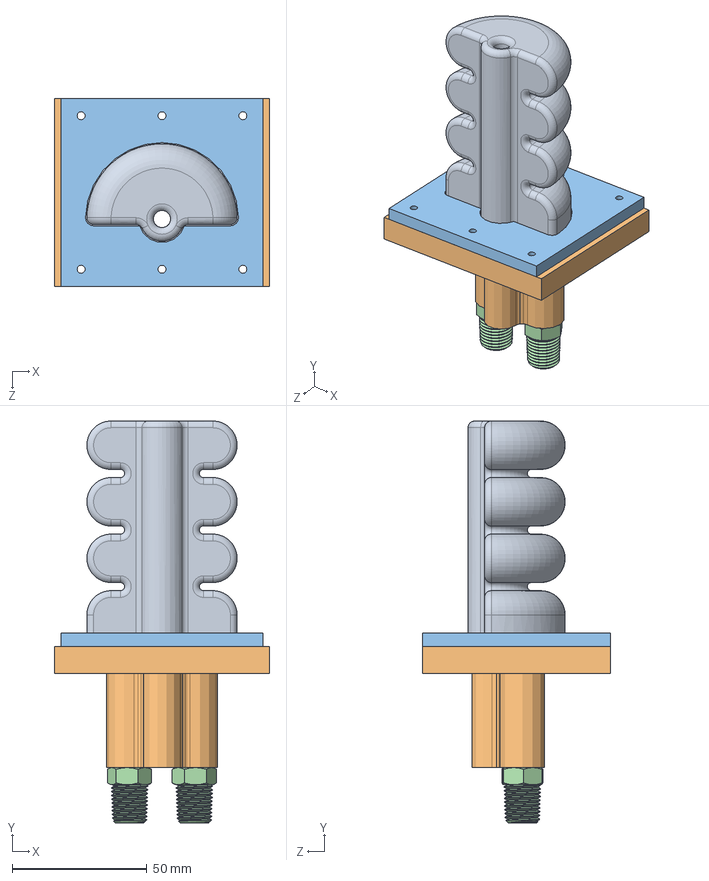
[picture p89: CAD file, 2023-04-17]
CAD/Smart Nozzle Designs/FlangedModel/FlangedModel.SLDASM
80.0 x 149.3 x 70.0 mm
2 chamber_Taurus_Flanged
BottomPlate_2Chm
TopCap_4mm
5350K32_Zinc-Plated Steel Barbed Hose Fitting x 2
