University-of-Dayton-DIMLab/Smart-Nozzle/Documentation/Smart Hose/Completed Model 3 chambers.SLDPRT

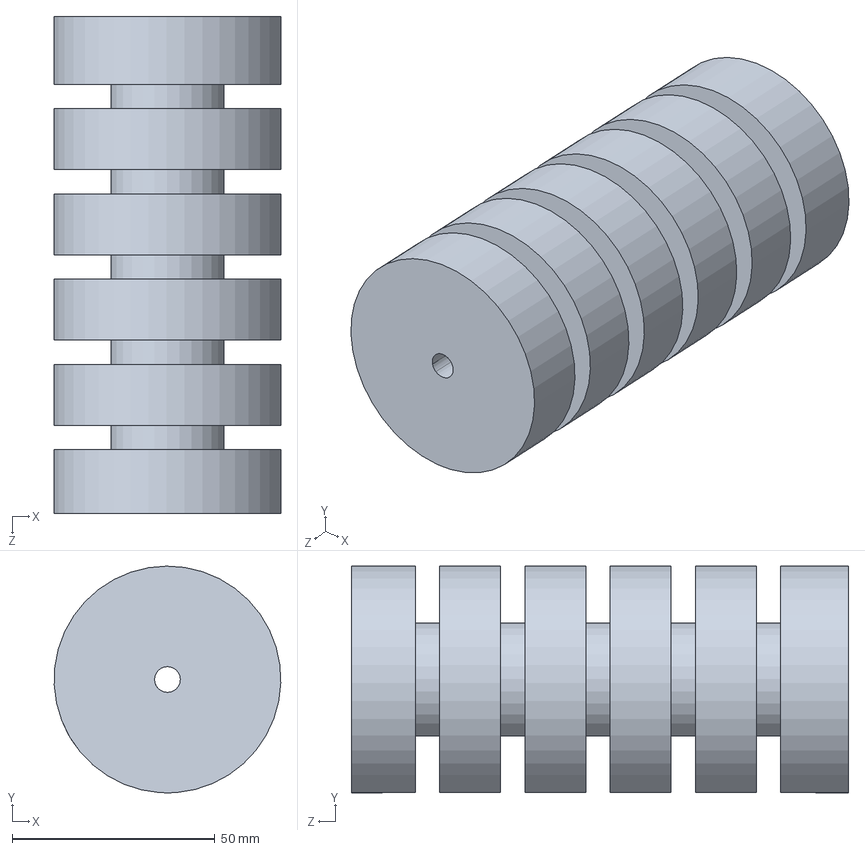
[picture p90: CAD file, 2023-04-17]
Documentation/Smart Hose/Completed Model 3 chambers.SLDPRT
55.8 x 55.9 x 122.5 mm
