University-of-Dayton-DIMLab/Smart-Nozzle/Documentation/Smart Hose/Completed Model bent.SLDPRT

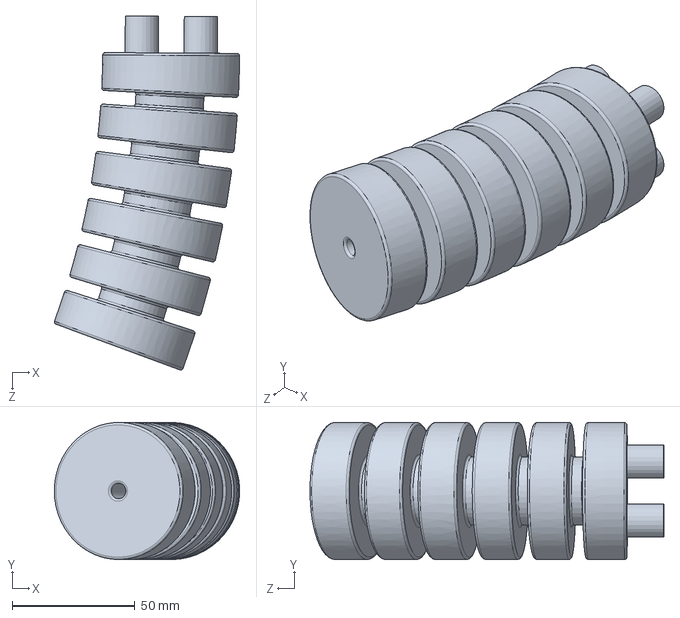
[picture p91: CAD file, 2023-04-17]
Documentation/Smart Hose/Completed Model bent.SLDPRT
75.6 x 55.9 x 144.3 mm
