University-of-Dayton-DIMLab/Smart-Nozzle/CAD/Smart Nozzle Designs/2 chamber highlighter long.SLDPRT

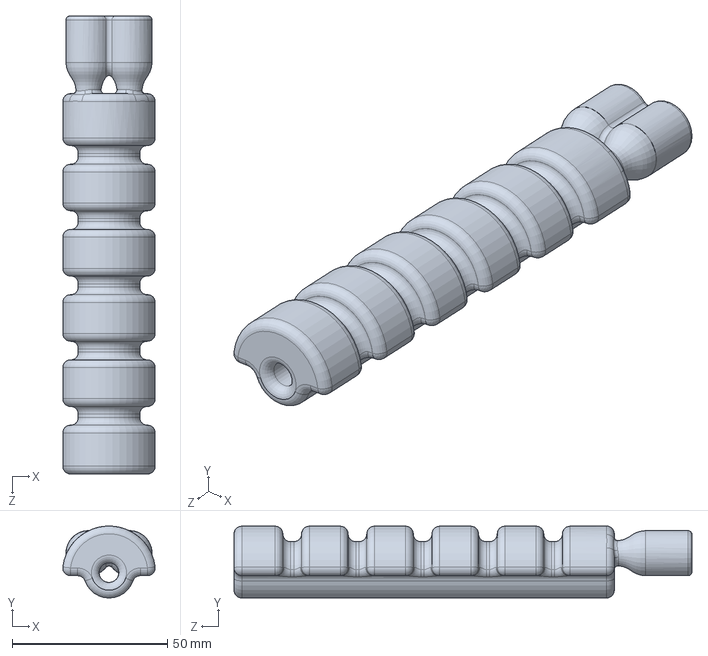
[picture p92: CAD file, 2023-04-17]
CAD/Smart Nozzle Designs/2 chamber highlighter long.SLDPRT
29.8 x 23.2 x 147.5 mm
