University-of-Dayton-DIMLab/Smart-Nozzle/CAD/Smart Nozzle Designs/FlangedModel/TopPlate.SLDPRT

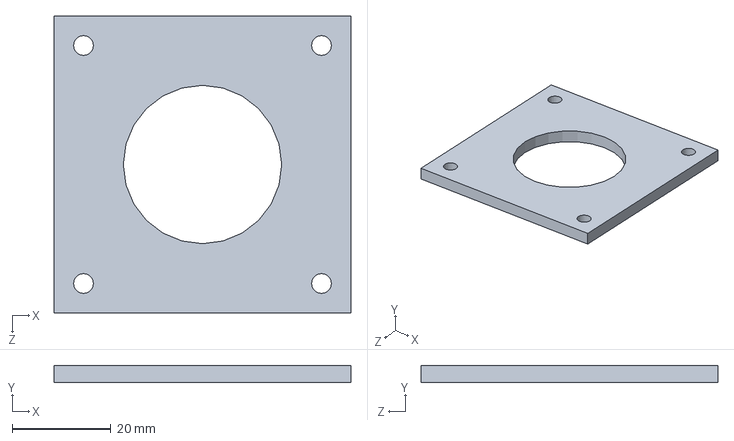
[picture p93: CAD file, 2023-04-17]
CAD/Smart Nozzle Designs/FlangedModel/TopPlate.SLDPRT
60.0 x 3.50 x 60.0 mm
