University-of-Dayton-DIMLab/Smart-Nozzle/CAD/Tensile Test/ASTM D412 Type C - Dogbone Specimen.SLDPRT

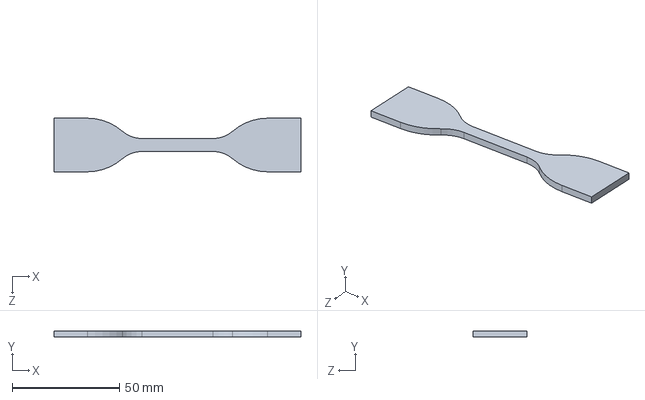
[picture p94: CAD file, 2023-04-17]
CAD/Tensile Test/ASTM D412 Type C - Dogbone Specimen.SLDPRT
115.0 x 3.00 x 25.0 mm
