University-of-Dayton-DIMLab/Smart-Nozzle/Documentation/Smart Hose/Displacement Chart Tests/2 chamber design maximum width.SLDPRT

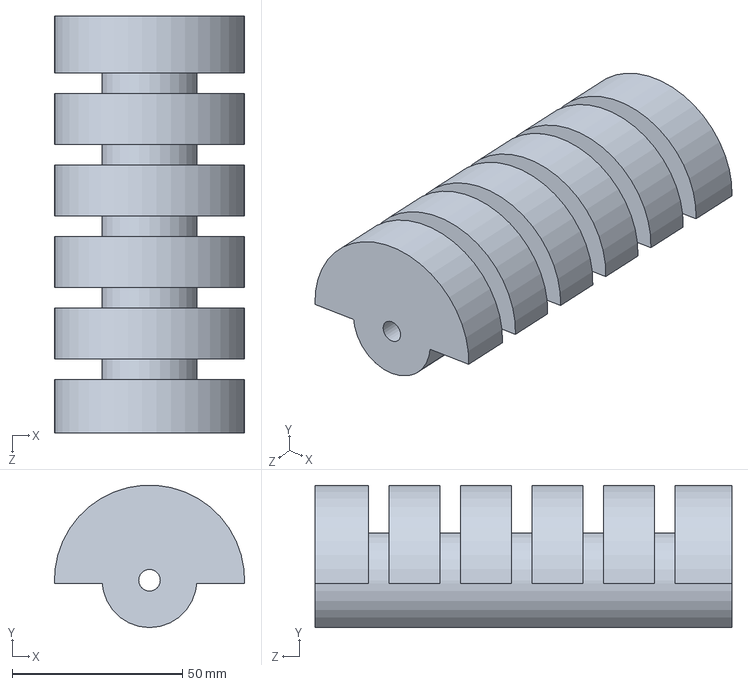
[picture p95: CAD file, 2023-04-17]
Documentation/Smart Hose/Displacement Chart Tests/2 chamber design maximum width.SLDPRT
55.8 x 41.8 x 122.5 mm
