University-of-Dayton-DIMLab/Smart-Nozzle/Documentation/Smart Hose/Two Nozzles on Two Chambers.SLDPRT

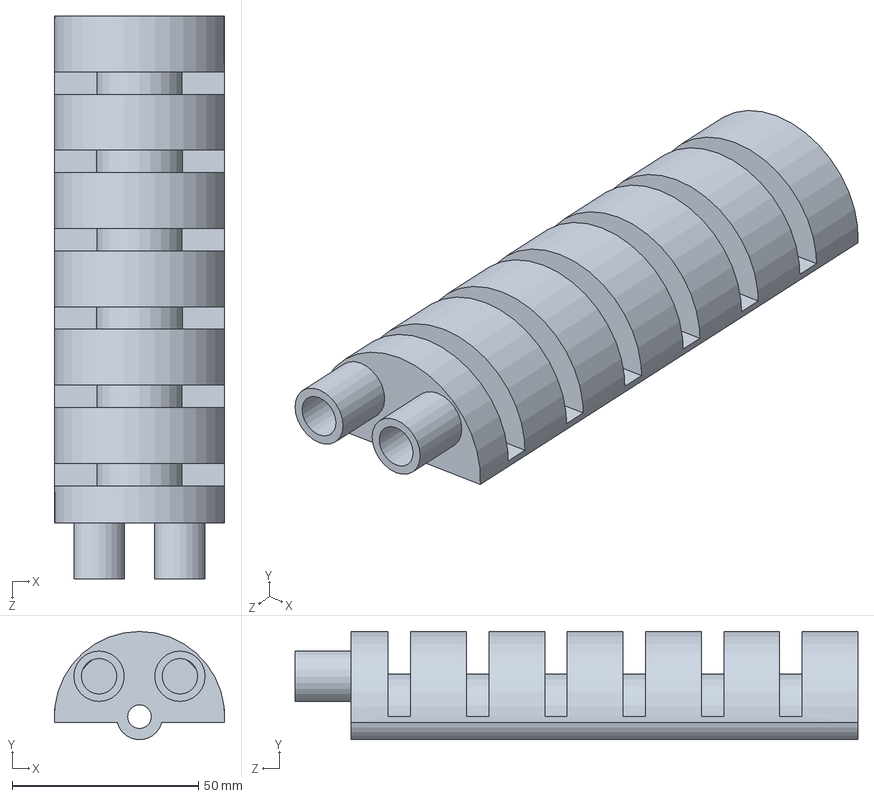
[picture p96: CAD file, 2023-04-17]
Documentation/Smart Hose/Two Nozzles on Two Chambers.SLDPRT
45.7 x 29.0 x 151.0 mm
