University-of-Dayton-DIMLab/Smart-Nozzle/CAD/Smart Nozzle Designs/2 chamber Taurus highlighter short.SLDPRT

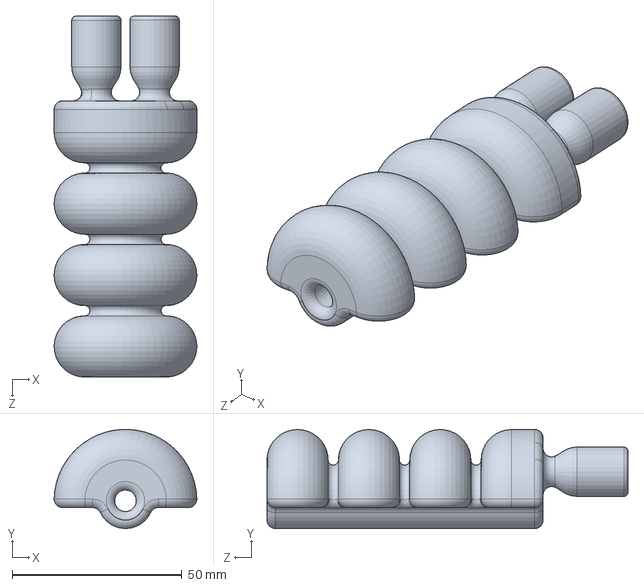
[picture p97: CAD file, 2023-04-17]
CAD/Smart Nozzle Designs/2 chamber Taurus highlighter short.SLDPRT
42.0 x 29.2 x 106.2 mm
