University-of-Dayton-DIMLab/Smart-Nozzle/Documentation/Smart Hose/2 chamber design 5mm radius.SLDPRT

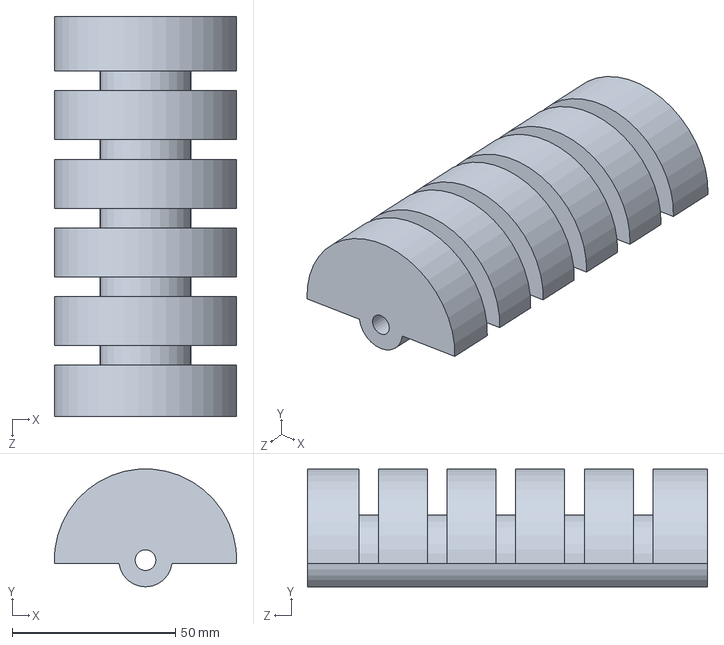
[picture p98: CAD file, 2023-04-17]
Documentation/Smart Hose/2 chamber design 5mm radius.SLDPRT
55.8 x 36.0 x 122.5 mm
