University-of-Dayton-DIMLab/Smart-Nozzle/CAD/Smart Nozzle Designs/2 chamber highlighter short.SLDPRT

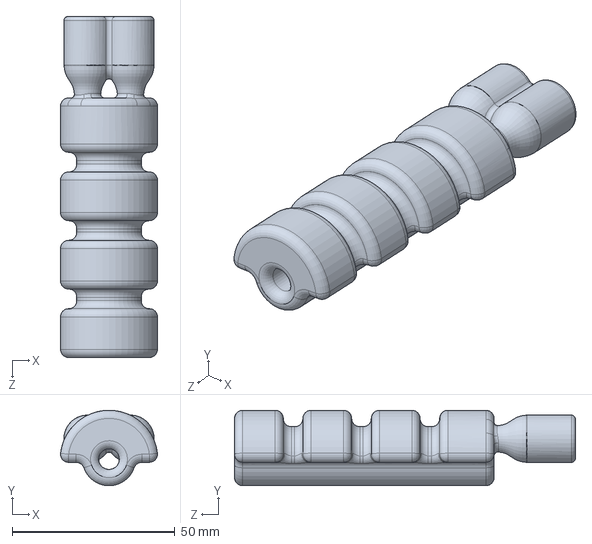
[picture p99: CAD file, 2023-04-17]
CAD/Smart Nozzle Designs/2 chamber highlighter short.SLDPRT
29.8 x 23.2 x 104.7 mm
