University-of-Dayton-DIMLab/Smart-Nozzle/CAD/Smart Nozzle Designs/FlangedModel/2 chamber_Taurus_Flanged.SLDPRT

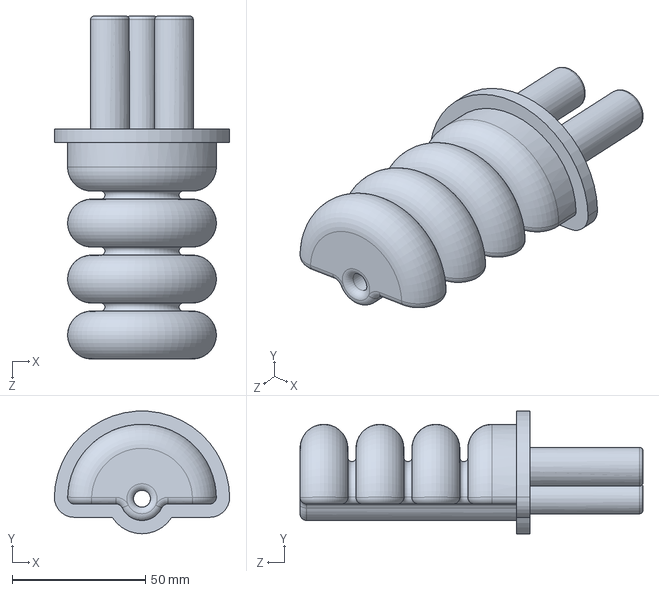
[picture p100: CAD file, 2023-04-17]
CAD/Smart Nozzle Designs/FlangedModel/2 chamber_Taurus_Flanged.SLDPRT
65.8 x 46.0 x 128.7 mm
