University-of-Dayton-DIMLab/Smart-Nozzle/Documentation/Smart Hose/Displacement Chart Tests/3 Chamber Nozzle.SLDPRT

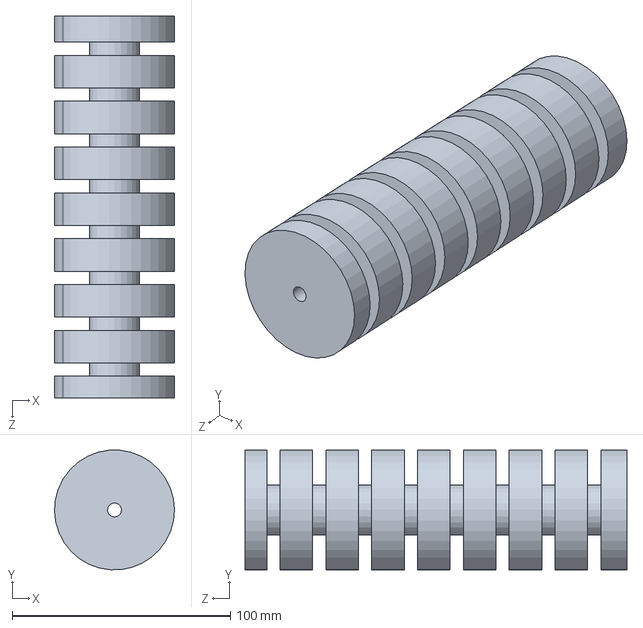
[picture p101: CAD file, 2023-04-17]
Documentation/Smart Hose/Displacement Chart Tests/3 Chamber Nozzle.SLDPRT
55.0 x 54.8 x 175.0 mm
