University-of-Dayton-DIMLab/Smart-Nozzle/CAD/Smart Nozzle Designs/FlangedModel/TopCap_4mm.SLDPRT

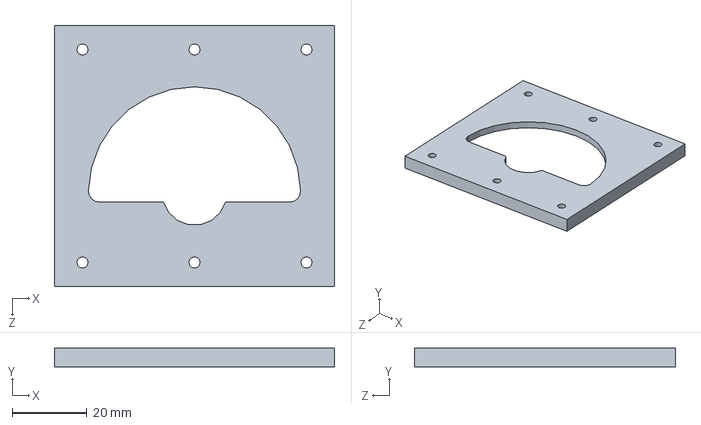
[picture p102: CAD file, 2023-04-17]
CAD/Smart Nozzle Designs/FlangedModel/TopCap_4mm.SLDPRT
75.0 x 5.00 x 70.0 mm
