University-of-Dayton-DIMLab/Smart-Nozzle/CAD/Smart Nozzle Designs/High Pressure Model Print Model.SLDPRT

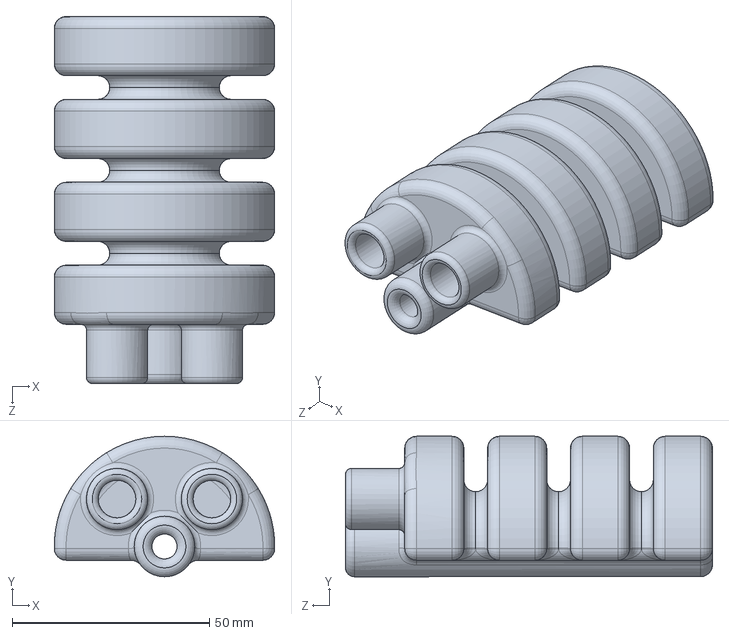
[picture p103: CAD file, 2023-04-17]
CAD/Smart Nozzle Designs/High Pressure Model Print Model.SLDPRT
55.9 x 35.6 x 93.0 mm
