University-of-Dayton-DIMLab/Smart-Nozzle/CAD/Smart Nozzle Designs/2 chamber Taurus short.SLDPRT

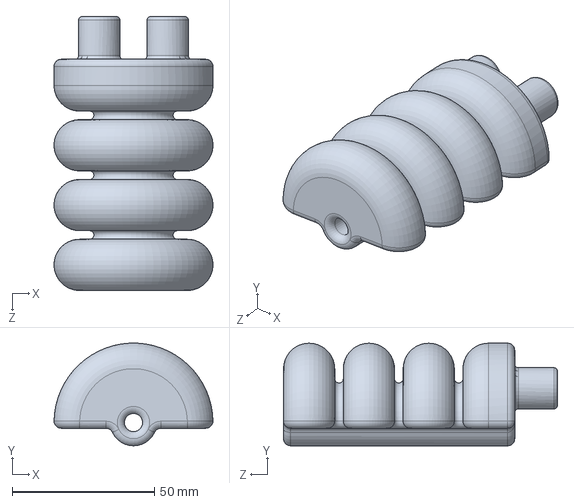
[picture p104: CAD file, 2023-04-17]
CAD/Smart Nozzle Designs/2 chamber Taurus short.SLDPRT
55.8 x 36.1 x 96.2 mm
