University-of-Dayton-DIMLab/Smart-Nozzle/CAD/Smart Nozzle Designs/FlangedModel/PlateDesign.SLDPRT

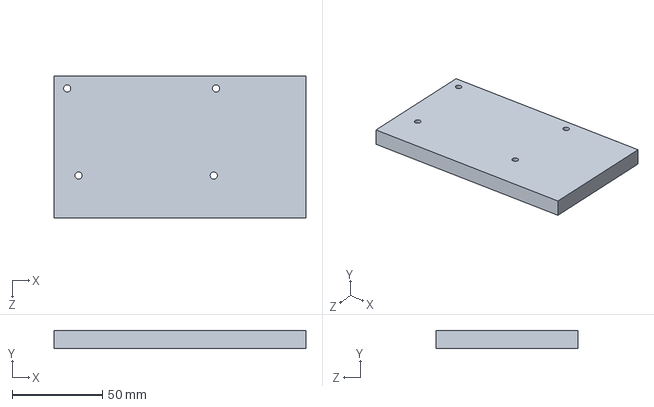
[picture p105: CAD file, 2023-04-17]
CAD/Smart Nozzle Designs/FlangedModel/PlateDesign.SLDPRT
139.7 x 10.0 x 78.7 mm
