University-of-Dayton-DIMLab/Smart-Nozzle/Documentation/Smart Hose/Nozzle on One Chamber.SLDPRT

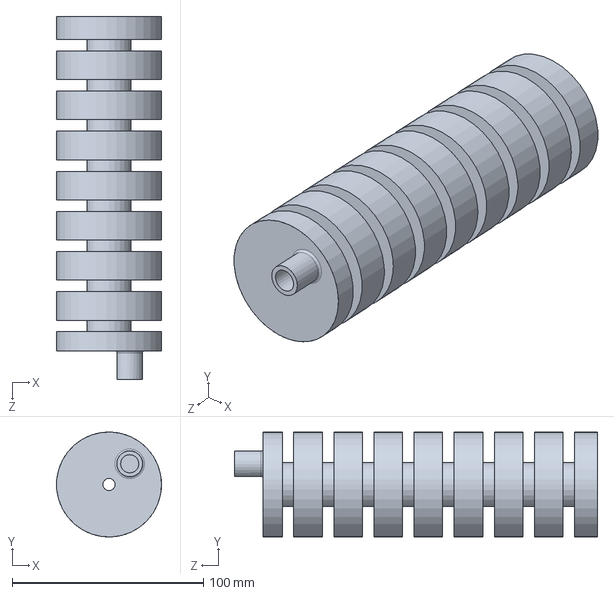
[picture p106: CAD file, 2023-04-17]
Documentation/Smart Hose/Nozzle on One Chamber.SLDPRT
55.0 x 54.9 x 190.0 mm
