University-of-Dayton-DIMLab/Smart-Nozzle/CAD/Smart Nozzle Designs/2 chamber Taurus highlighter long.SLDPRT

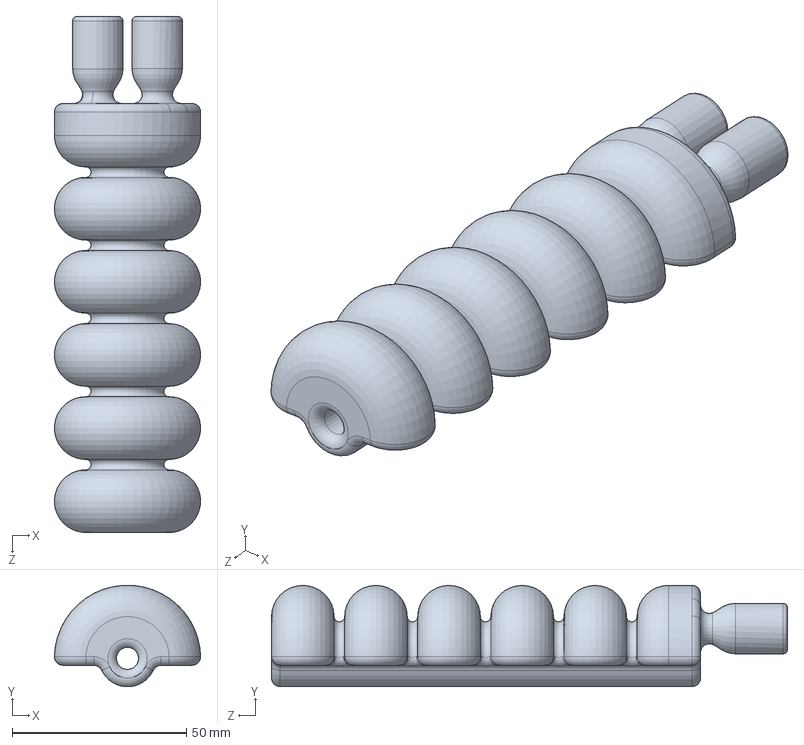
[picture p107: CAD file, 2023-04-17]
CAD/Smart Nozzle Designs/2 chamber Taurus highlighter long.SLDPRT
42.0 x 29.1 x 148.2 mm
