University-of-Dayton-DIMLab/Smart-Nozzle/CAD/Smart Nozzle Designs/FlangedModel/BottomPlate_2Chm.SLDPRT

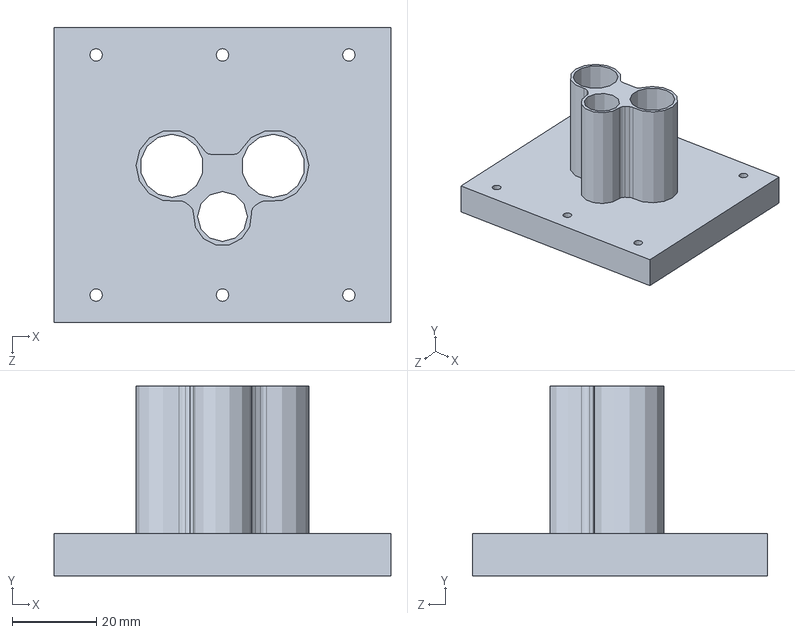
[picture p108: CAD file, 2023-04-17]
CAD/Smart Nozzle Designs/FlangedModel/BottomPlate_2Chm.SLDPRT
80.0 x 45.0 x 70.0 mm
