University-of-Dayton-DIMLab/Smart-Nozzle/Documentation/Smart Hose/Displacement Chart Tests/2 chamber design 4mm radius.SLDPRT

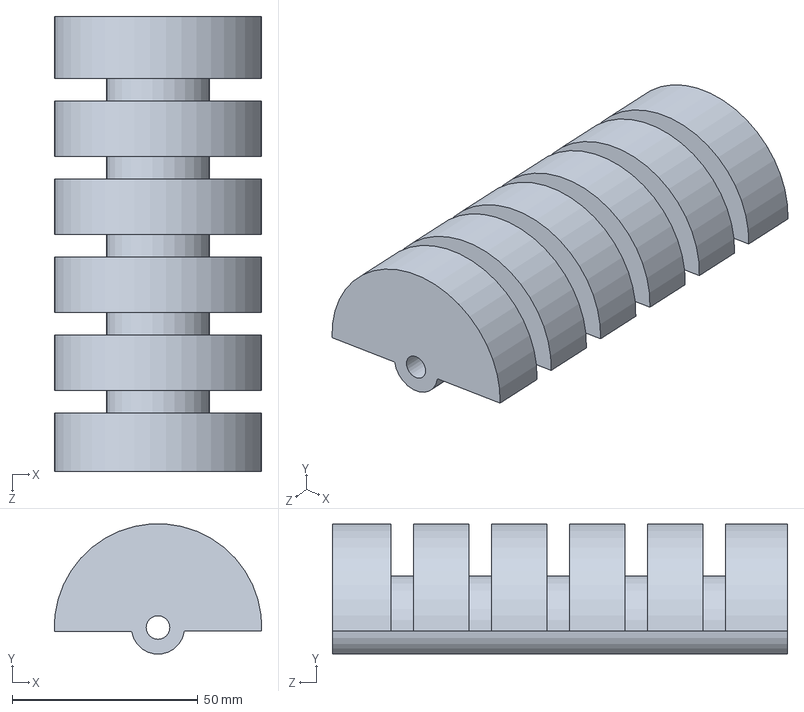
[picture p109: CAD file, 2023-04-17]
Documentation/Smart Hose/Displacement Chart Tests/2 chamber design 4mm radius.SLDPRT
55.8 x 35.0 x 122.5 mm
