University-of-Dayton-DIMLab/Smart-Nozzle/Documentation/Smart Hose/Displacement Chart Tests/2 chamber design 6mm radius.SLDPRT

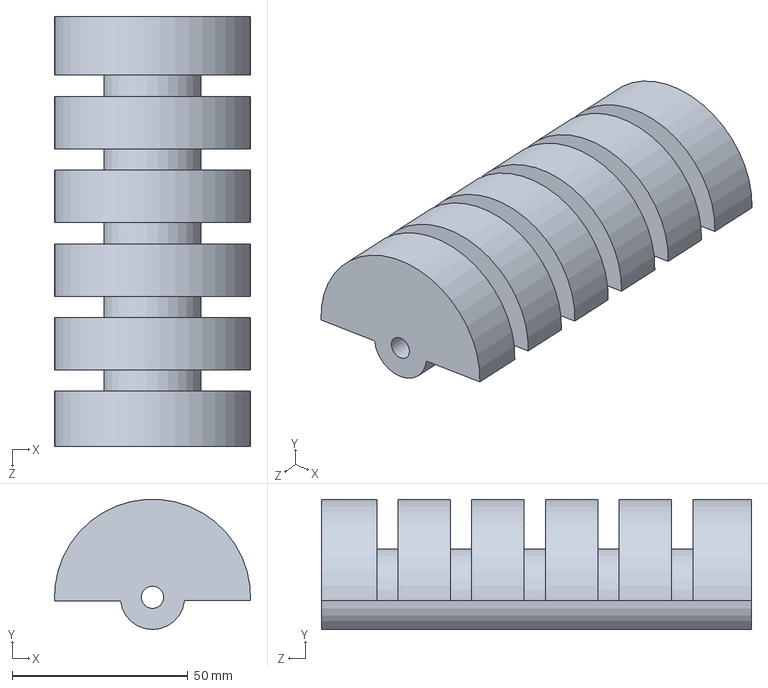
[picture p110: CAD file, 2023-04-17]
Documentation/Smart Hose/Displacement Chart Tests/2 chamber design 6mm radius.SLDPRT
55.8 x 37.0 x 122.5 mm
