University-of-Dayton-DIMLab/Smart-Nozzle/Documentation/Smart Hose/Displacement Chart Tests/2 chamber design 3mm radius.SLDPRT

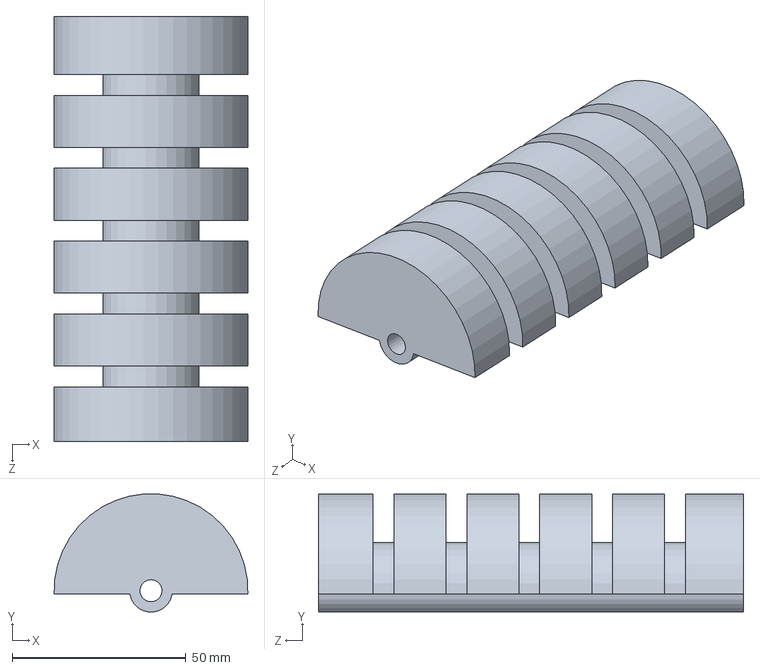
[picture p111: CAD file, 2023-04-17]
Documentation/Smart Hose/Displacement Chart Tests/2 chamber design 3mm radius.SLDPRT
55.8 x 34.0 x 122.5 mm
