University-of-Dayton-DIMLab/Smart-Nozzle/(list of files, cad)

Other CAD files:
Documentation/Smart Hose/Displacement Chart Tests/Completed Model C1-10 C2-25.SLDPRT
Documentation/Smart Hose/Completed Model.SLDPRT
Documentation/Smart Hose/Displacement Chart Tests/Completed Model C1-10 C2-10.SLDPRT
Documentation/Smart Hose/Displacement Chart Tests/Completed Model C1-10 C2-20.SLDPRT
Documentation/Smart Hose/Displacement Chart Tests/Completed Model Validation C1.SLDPRT
Documentation/Smart Hose/Displacement Chart Tests/Completed Model C1-10 C2-15.SLDPRT
Documentation/Smart Hose/Displacement Chart Tests/Completed Model C1-10 C2-30.SLDPRT
Documentation/Smart Hose/Displacement Chart Tests/Completed Model Validation C2.SLDPRT
Documentation/Smart Hose/Displacement Chart Tests/Completed Model C1-15 C2-20.SLDPRT
Documentation/Smart Hose/Displacement Chart Tests/Completed Model C1-0 C2-15.SLDPRT
Documentation/Smart Hose/Displacement Chart Tests/Completed Model C1-0 C2-20.SLDPRT
Documentation/FEA Tutorial/Smart Nozzle Tutorial.SLDPRT
Documentation/Smart Hose/Hose.SLDPRT
Documentation/Smart Hose/Nozzle on Two Chamber.SLDPRT
CAD/Smart Nozzle Designs/FlangedModel/5350K32_Zinc-Plated Steel Barbed Hose Fitting.SLDPRT
CAD/Smart Nozzle Designs/Retired Models/Attachment Cap.SLDPRT
CAD/Smart Nozzle Designs/Retired Models/High Pressure Model Attachment Cap.SLDPRT
CAD/Tensile Test/ASTM D412 Type C - Dogbone Specimen.STL
Documentation/Smart Hose/Completed Model(1).SLDPRT
Documentation/Smart Hose/Displacement Chart Tests/Completed Model C1-0 C2-15(1).SLDPRT
Documentation/Smart Hose/Two Nozzles on Two Chambers(1).SLDPRT
