University-of-Dayton-DIMLab/Smart-Nozzle/Documentation/Material Properties/MyszkasTensionTest w Avg Linear Fit.xlsx

E, psi | 860
B, in | 0.25
H, in | 0.5 |  | Eng Stress/Strain |  | True Stress/Strain |  |  | SolidWorks Probe
 |  | Load, F | Stress, s | Strain, e | Stress | Strain |  | Stress, s | Strain, e
 |  | (lbs) | (psi) | (in/in) | (psi) | (in/in) |  | (psi) | (in/in)
 |  | 3 | 24 | 0.0279 | 0.2 | 0.0275 | 24.50 | 0.1689655172 | 0.0277 | TRUE
 |  | 5 | 40 | 0.0465 | 0.3 | 0.0455 | 41.79 | 0.2882068966 | 0.0470 |  | 0 | 0
 |  | 8 | 64 | 0.0744 | 0.5 | 0.0718 | 68.77 | 0.4742758621 | 0.0773 |  | 0.35 | 2.021995
 |  | 12 | 96 | 0.1116 | 0.7 | 0.1058 | 107.41 | 0.7407586207 | 0.1027 | 5.777128571
 |  | 20 | 160 | 0.1860 | 1.3 | 0.1706 | 186.14 | 1.283724138 | 0.1948 |  |  |  | True Strain | True Stress
 |  | 25 | 200 | 0.2326 | 1.7 | 0.2091 | 243.84 | 1.681655172 | 0.2552 |  |  |  | 4.199911802e-05 | 9.99968e-05
 |  | 30 | 240 | 0.2791 | 2.1 | 0.2461 | 308.32 | 2.126344828 | 0.3227 |  |  |  | 0.0002039791948 | 0.0001999928
 |  |  |  |  |  |  |  |  |  |  |  |  | 0.0004708891143 | 0.0004999835
 |  |  |  |  |  |  |  |  |  |  |  |  | 0.0007477203874 | 0.0011999748
 |  |  |  |  |  |  |  |  |  |  |  |  | 0.0009935063091 | 0.002999922
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
