University-of-Dayton-DIMLab/Smart-Nozzle/(commit log)

2023-04-17 Renamed Documents to Documentation
    [2 chamber design 3mm radius.SLDPRT, 2 chamber design 4mm radius.SLDPRT, 2 chamber design 5mm radius.SLDPRT, 2 chamber design 6mm radius.SLDPRT, 2 chamber design maximum width.SLDPRT, 3 Chamber Nozzle.SLDPRT, Completed Model 3 chambers.SLDPRT, Completed Model C1-0 C2-15(1).SLDPRT]
2023-08-30 Added John's Code from Spring 2023
